asheryoung10/seniorProject/Pictures/BothSidesOfShell.jpg

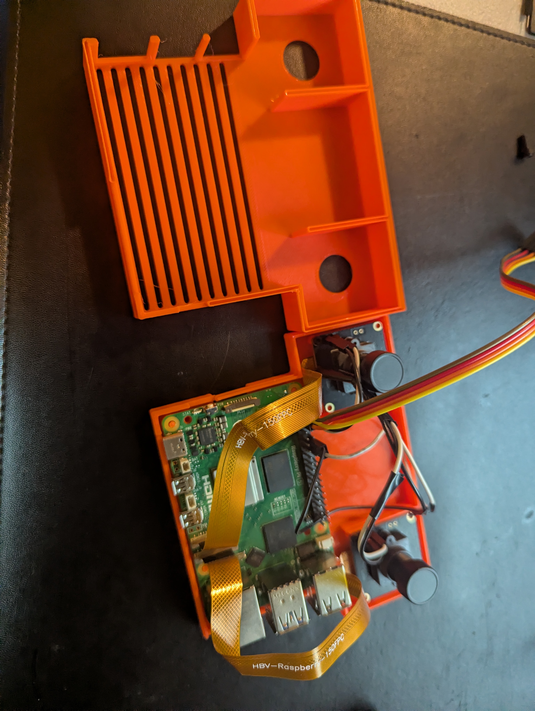
Pictures/BothSidesOfShell.jpg
