asheryoung10/seniorProject/Pictures/Cameras.webp

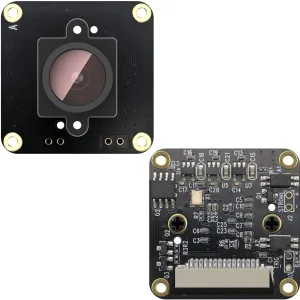
Pictures/Cameras.webp
