asheryoung10/seniorProject/Pictures/completeDevicePluggedIn.jpg

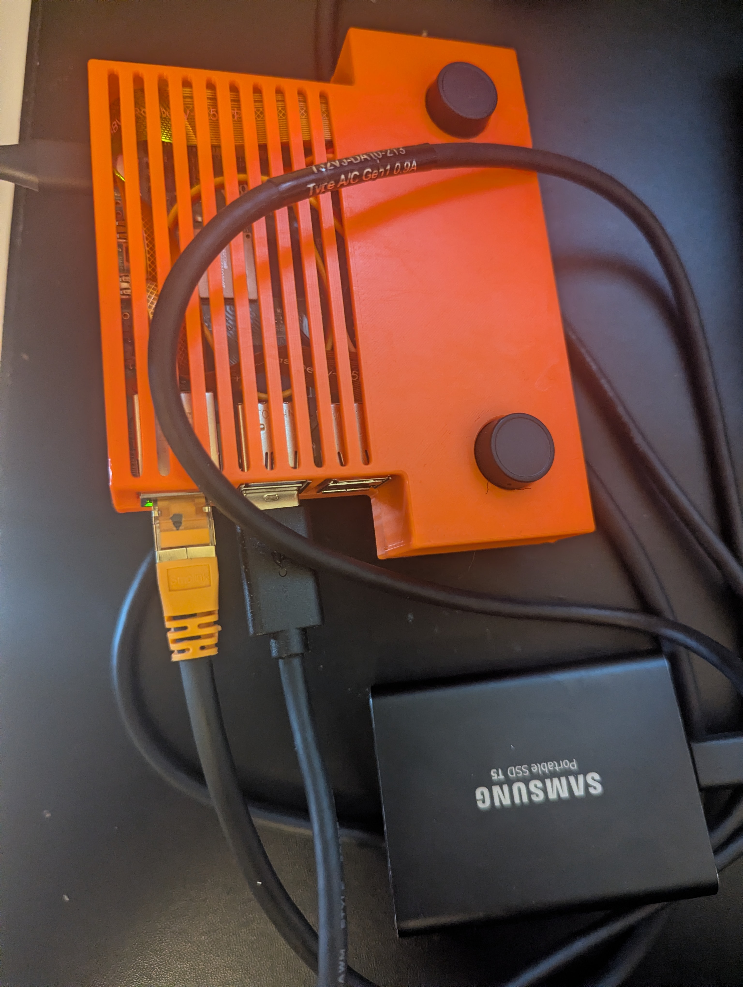
Pictures/completeDevicePluggedIn.jpg
