asheryoung10/seniorProject/Pictures/deviceNoTopShell.jpg

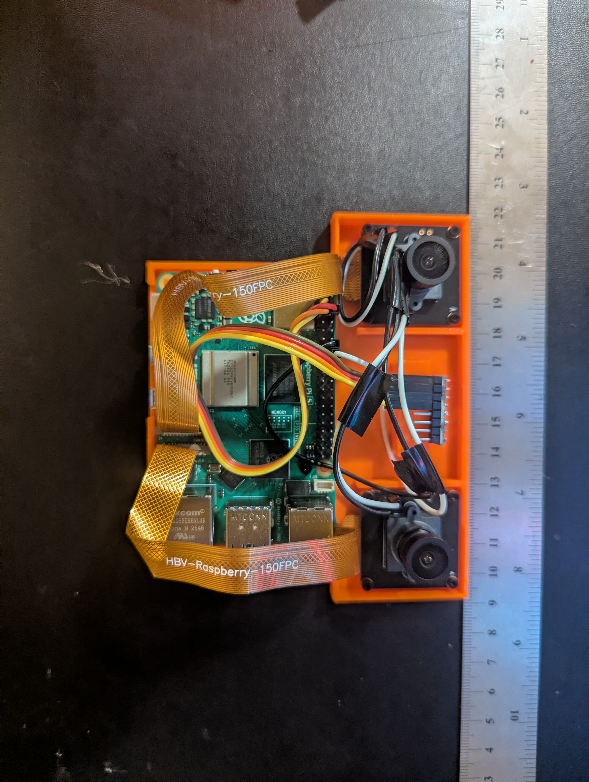
Pictures/deviceNoTopShell.jpg
