asheryoung10/seniorProject/Rasp_UPS_5A/KiCad/USB_UPS_Raspberry.csv

Reference | Qty | Value | DNP | Exclude from BOM | Footprint | MPN#
FID1,FID2,FID3 | 3 | Fiducial | DNP | Excluded from BOM | Fiducial:Fiducial_0.5mm_Mask1mm
U4 | 1 | BQ21040DBV |  |  | Package_TO_SOT_SMD:SOT-23-6 | BQ21040DBVR
U3 | 1 | BQ297xy |  |  | Package_SON:WSON-6_1.5x1.5mm_P0.5mm | BQ29700DSER
U2 | 1 | TPS61089 |  |  | Package_DFN_QFN:Texas_VQFN-RNR0011A-11 | TPS61089RNRR
U1 | 1 | BH-18650-B5BA016 |  |  | xresource_kicadlibrary:BH-18650-B5BA016 | BH-18650-B5BA016
R9 | 1 | 1k8 |  |  | Resistor_SMD:R_0603_1608Metric | RT0603BRD071K8L
R8 | 1 | 330 |  |  | Resistor_SMD:R_0603_1608Metric | RT0603BRE07330RL
R7,R11 | 2 | 2k2 |  |  | Resistor_SMD:R_0603_1608Metric | RT0603BRD072K2L
R5 | 1 | 33k |  |  | Resistor_SMD:R_0603_1608Metric | RT0603BRD0733KL
R4 | 1 | 17k4 |  |  | Resistor_SMD:R_0603_1608Metric | RT0603BRD0717K4L
R3 | 1 | 127k |  |  | Resistor_SMD:R_0603_1608Metric | RT0603FRE07127KL
R2 | 1 | 301k |  |  | Resistor_SMD:R_0603_1608Metric | RT0603BRE07301KL
R1,R6,R10 | 3 | 10k |  |  | Resistor_SMD:R_0603_1608Metric | RT0603BRD0710KL
Q2,Q3 | 2 | SI4134DY |  |  | Package_SO:SOIC-8_3.9x4.9mm_P1.27mm | SI4134DY-T1-GE3
Q1 | 1 | NTF6P02 |  |  | Package_TO_SOT_SMD:SOT-223-3_TabPin2 | NTF6P02T3G
L1 | 1 | 1u8 |  |  | Inductor_SMD:L_Bourns_SRP6060FA | YSPIT0630A-1R8M
J2 | 1 | USB_A |  |  | Connector_USB:USB_A_Connfly_DS1095 | DS1095-BNR0
J1 | 1 | USB_C_Receptacle_PowerOnly_6P |  |  | Connector_USB:USB_C_Receptacle_HRO_TYPE-C-31-M-17 | GT-USB-7002A
F1,F2 | 2 | 300C-8V |  |  | Fuse:Fuse_1206_3216Metric | SMD1206-300C-8V
D2 | 1 | LED |  |  | LED_SMD:LED_0603_1608Metric | LTST-C193KSKT-5A
D1 | 1 | PMEG100V060ELPDZ |  |  | Package_TO_SOT_SMD:Nexperia_CFP15_SOT-1289 | PMEG100V060ELPDZ
C8,C13,C14 | 3 | 1uF |  |  | Capacitor_SMD:C_0603_1608Metric | CC0603KRX5R8BB105
C7 | 1 | 4n7 |  |  | Capacitor_SMD:C_0603_1608Metric | CC0603KRX7R8BB472
C6 | 1 | 4u7 |  |  | Capacitor_SMD:C_0603_1608Metric | GRM188R61E475KE11D
C2,C3,C4,C9,C10,C11 | 6 | 22uF |  |  | Capacitor_SMD:C_0603_1608Metric | GRM188R61C226ME01D
C1,C5,C12 | 3 | 100nF |  |  | Capacitor_SMD:C_0603_1608Metric | CC0603KRX7R8BB104
