asheryoung10/seniorProject/CAD/Version2/assembly-front.stl

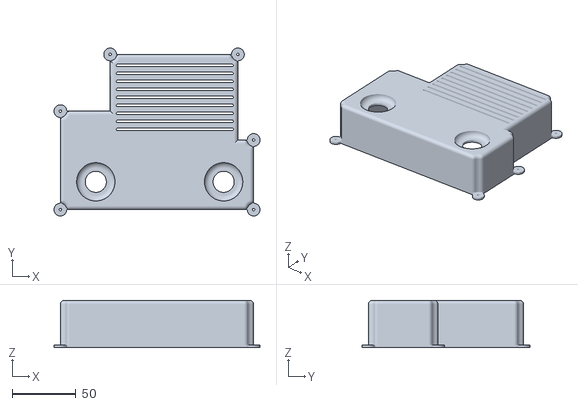
[picture p11: CAD file, 2026-10-17]
CAD/Version2/assembly-front.stl
161.2 x 131.4 x 37.0
