asheryoung10/seniorProject/CAD/Version2/assembly.FCStd

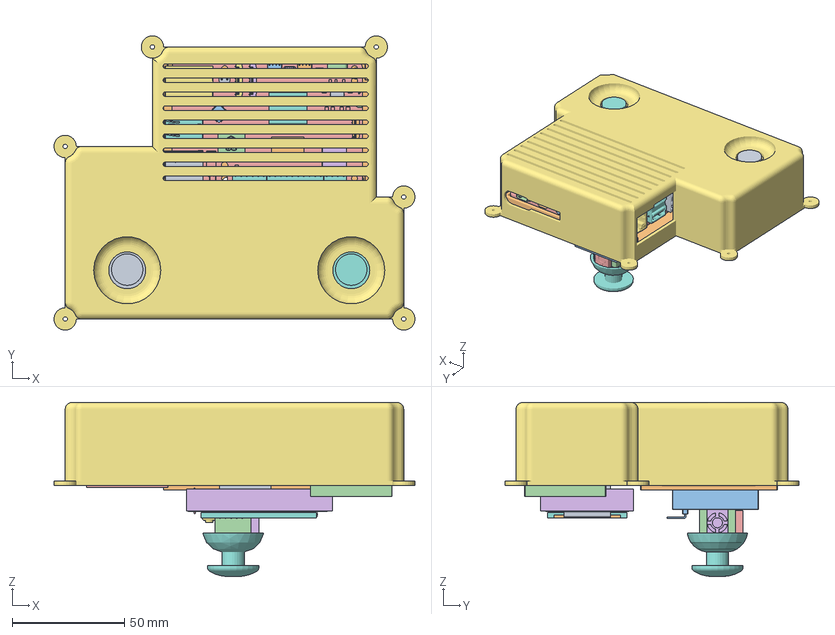
[picture p12: CAD file, 2026-10-17]
CAD/Version2/assembly.FCStd
161.1 x 131.4 x 77.7 mm
MPU6050 v001
MPU6050 v002
MPU6050 v003
MPU6050 v004
MPU6050 v005
MPU6050 v006
MPU6050 v007
MPU6050 v008
MPU6050 v009
MPU6050 v010
MPU6050 v011
MPU6050 v012
MPU6050 v013
MPU6050 v014
MPU6050 v015
MPU6050 v016
MPU6050 v017
MPU6050 v018
MPU6050 v019
MPU6050 v020
MPU6050 v021
MPU6050 v022
MPU6050 v023
MPU6050 v024
MPU6050 v025
MPU6050 v026
MPU6050 v027
MPU6050 v028
MPU6050 v029
MPU6050 v030
MPU6050 v031
MPU6050 v032
MPU6050 v033
MPU6050 v034
MPU6050 v035
MPU6050 v036
MPU6050 v037
MPU6050 v038
MPU6050 v039
MPU6050 v040
MPU6050 v041
MPU6050 v042
MPU6050 v043
MPU6050 v044
MPU6050 v045
MPU6050 v046
MPU6050 v047
MPU6050 v048
MPU6050 v049
MPU6050 v050
MPU6050 v051
MPU6050 v052
PLATE_RASPBERRY_PI_5
METAL_PLATE.
GIGABIT_ETHERNET_PORT
2xUSB_3.0_PORT
2xUSB_2.0_PORT
FEMALE_MICRO_HDMI_CONNECTOR
FEMALE_MICRO_HDMI_CONNECTOR001
FEMALE_USB_CONNECTOR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
