asheryoung10/seniorProject/CAD/Version2/assembly-back.stl

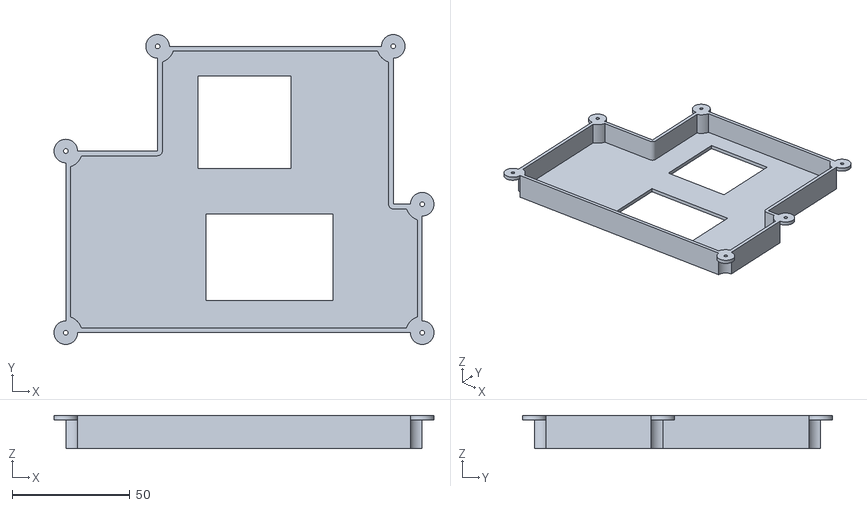
[picture p13: CAD file, 2026-10-17]
CAD/Version2/assembly-back.stl
161.2 x 131.4 x 14.0
