asheryoung10/seniorProject/CAD/RecorderHousing.3mf

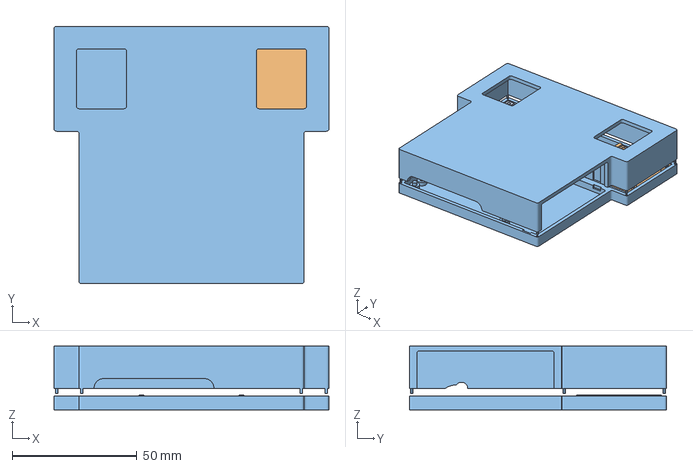
[picture p14: CAD file, 2026-08-28]
CAD/RecorderHousing.3mf
110.0 x 103.0 x 25.6 mm
