asheryoung10/seniorProject/CAD/Version2/6050Mount.FCStd

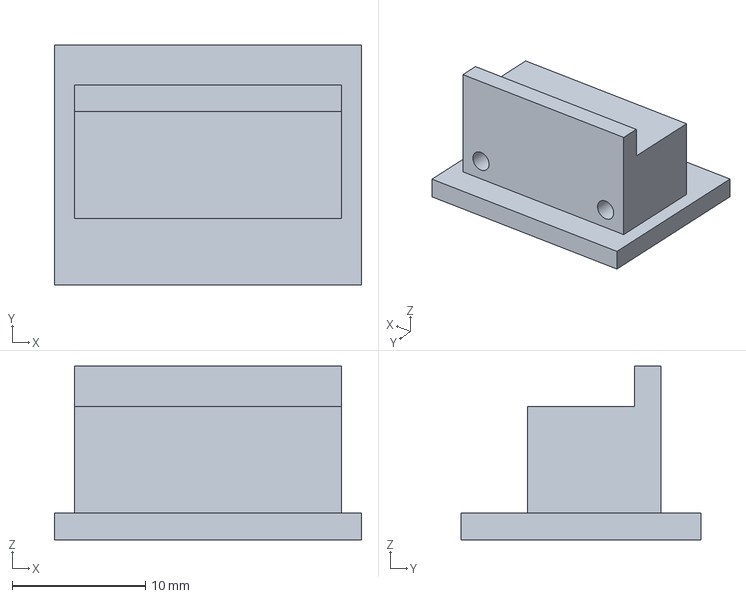
[picture p15: CAD file, 2026-10-17]
CAD/Version2/6050Mount.FCStd
23.0 x 18.0 x 13.0 mm
