asheryoung10/seniorProject/Rasp_UPS_5A/KiCad/USB_UPS_Raspberry.step

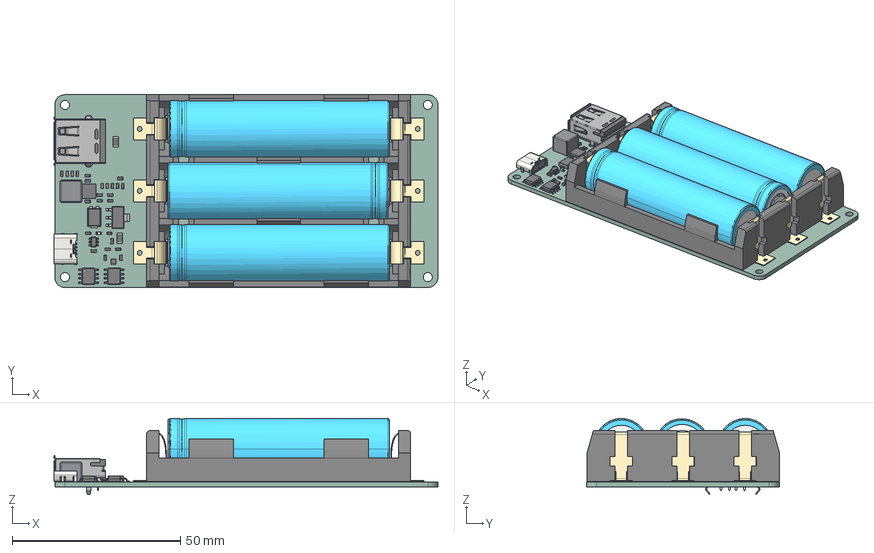
[picture p16: CAD file, 2026-10-31]
Rasp_UPS_5A/KiCad/USB_UPS_Raspberry.step
114.1 x 57.4 x 22.6 mm
C_0603_1608Metric x 14
Texas_S-PVQFN-N14
SOT-23-6
TO-277B
L_Bourns_SRP6060FA
R_0603_1608Metric x 11
Fuse_1206_3216Metric x 2
SOT-223
WSON-6_1.5x1.5mm_P0.5mm
SOIC-8_3.9x4.9mm_P1.27mm x 2
BatteryCasePlastic
BatteryCaseSpring x 6
Battery18650 x 3
LED_0603_1608Metric
USB_A_Molex_67643_Horizontal
USB_C_Receptacle_GCT_USB4125-xx-x_6P_TopMnt_Horizontal
USB_UPS_Raspberry_PCB
