asheryoung10/seniorProject/CAD/Version2/piMount.FCStd

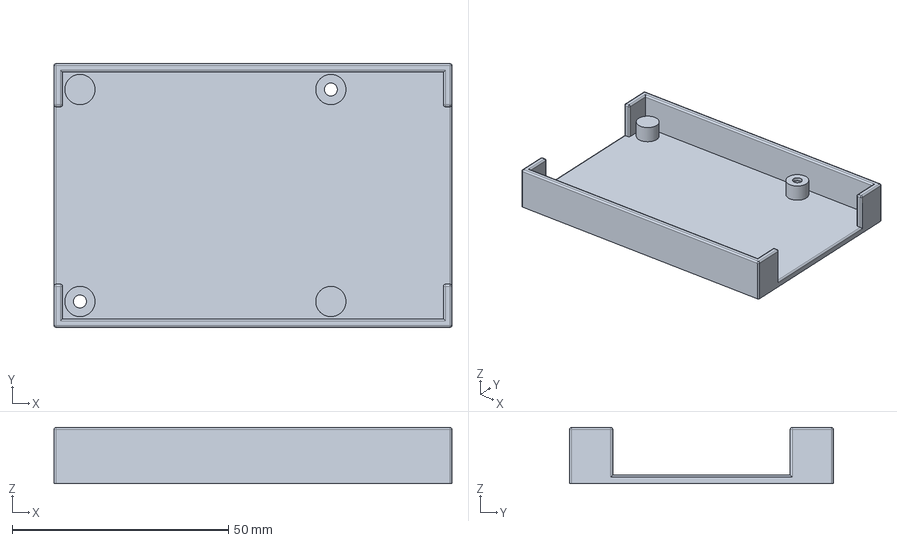
[picture p17: CAD file, 2026-10-17]
CAD/Version2/piMount.FCStd
92.0 x 61.0 x 13.0 mm
