asheryoung10/seniorProject/CAD/Version2/cameraMount.FCStd

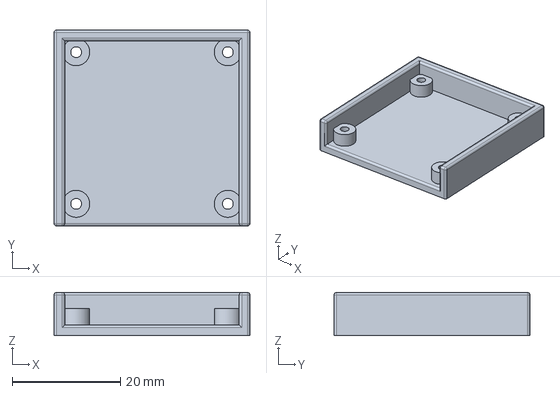
[picture p18: CAD file, 2026-10-17]
CAD/Version2/cameraMount.FCStd
36.2 x 36.2 x 8.00 mm
