asheryoung10/seniorProject/CAD/Version2/joystickMount.FCStd

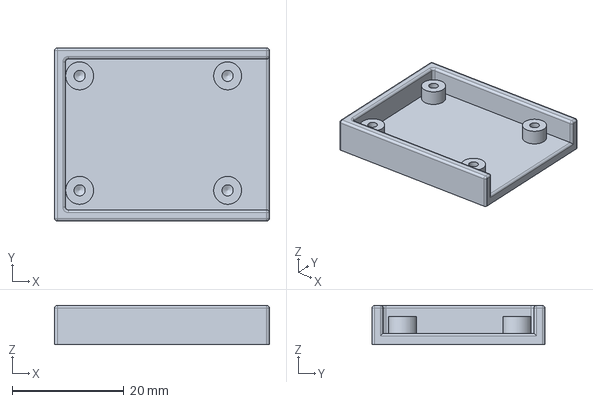
[picture p19: CAD file, 2026-10-17]
CAD/Version2/joystickMount.FCStd
38.5 x 31.0 x 7.00 mm
