asheryoung10/seniorProject/CAD/Version2/cameraModel.stl

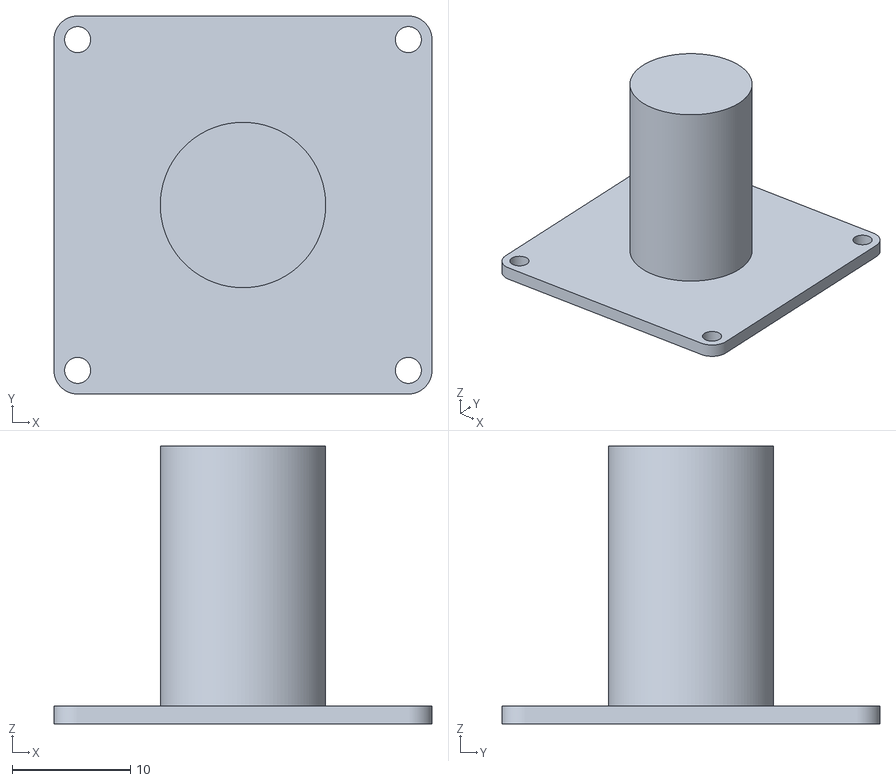
[picture p20: CAD file, 2026-10-17]
CAD/Version2/cameraModel.stl
32.0 x 32.0 x 23.5
