asheryoung10/seniorProject/CAD/Version2/displayMount-Body.stl

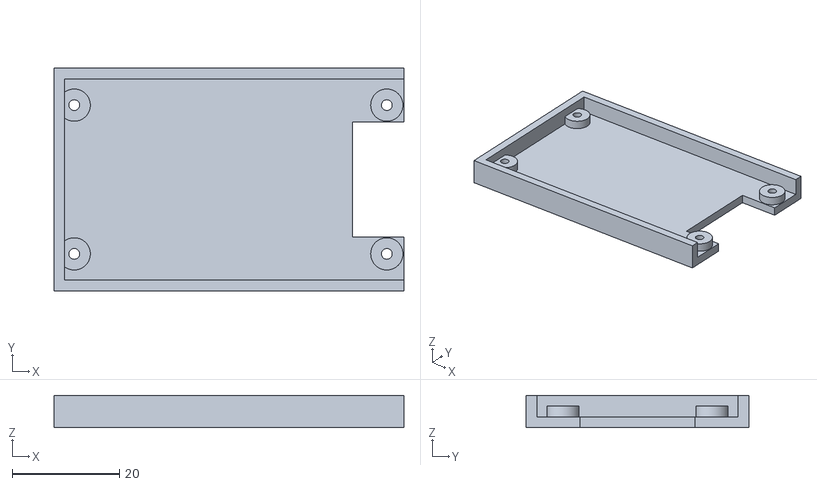
[picture p21: CAD file, 2026-10-17]
CAD/Version2/displayMount-Body.stl
65.2 x 41.5 x 6.00
