asheryoung10/seniorProject/CAD/Version2/base.stl

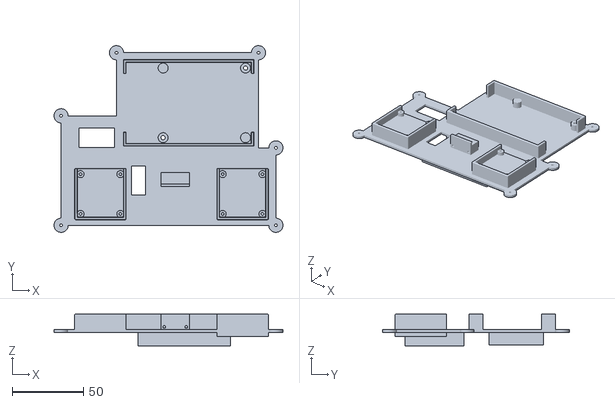
[picture p22: CAD file, 2026-10-17]
CAD/Version2/base.stl
161.2 x 131.4 x 22.5
