asheryoung10/seniorProject/CAD/Version2/displayMount.FCStd

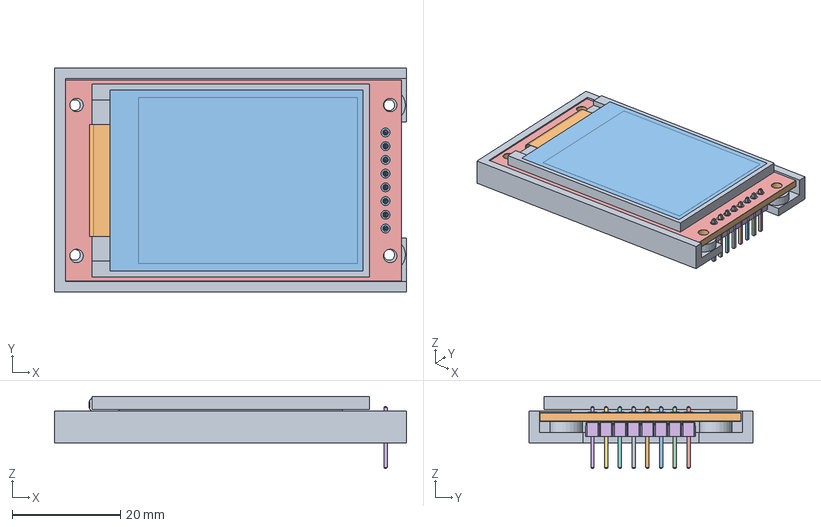
[picture p23: CAD file, 2026-10-17]
CAD/Version2/displayMount.FCStd
65.2 x 41.5 x 13.4 mm
Board
64-copper
1-soldermask
64-soldermask
6130xx11121_PIN
6130xx11121_PIN001
6130xx11121_PIN002
6130xx11121_PIN003
6130xx11121_PIN004
6130xx11121_PIN005
6130xx11121_PIN006
6130xx11121_PIN007
SOT23
DIODE_PGB-0603MP
DIODE_PGB-0603MP001
DIODE_PGB-0603MP002
DIODE_PGB-0603MP003
DIODE_PGB-0603MP004
5576557.f3d
5576557.f3d 001
5576557.f3d 002
5576557.f3d 003
5576557.f3d 004
5576557.f3d 005
5576557.f3d 006
CAP_0603
CAP_0604
SOT89
1-copper
Text
Screen support
Ribon cable
Glass
