asheryoung10/seniorProject/CAD/Version1/HousingVersion2-Bottom.3mf

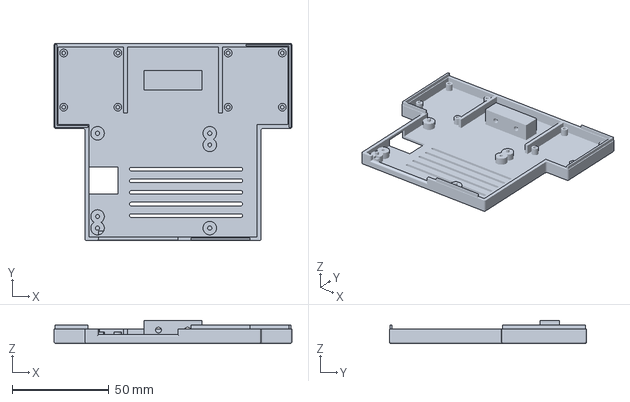
[picture p24: CAD file, 2026-10-17, an earlier design]
CAD/Version1/HousingVersion2-Bottom.3mf
123.0 x 102.0 x 12.0 mm
