asheryoung10/seniorProject/CAD/Version1/RecorderHousing-Bottom.3mf

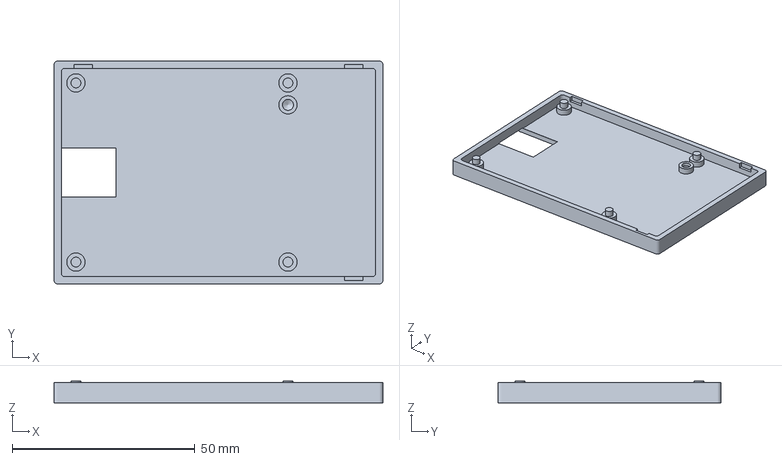
[picture p25: CAD file, 2026-10-17, an earlier design]
CAD/Version1/RecorderHousing-Bottom.3mf
90.0 x 61.0 x 6.00 mm
