asheryoung10/seniorProject/CAD/Version1/HousingVersion2-Cut.3mf

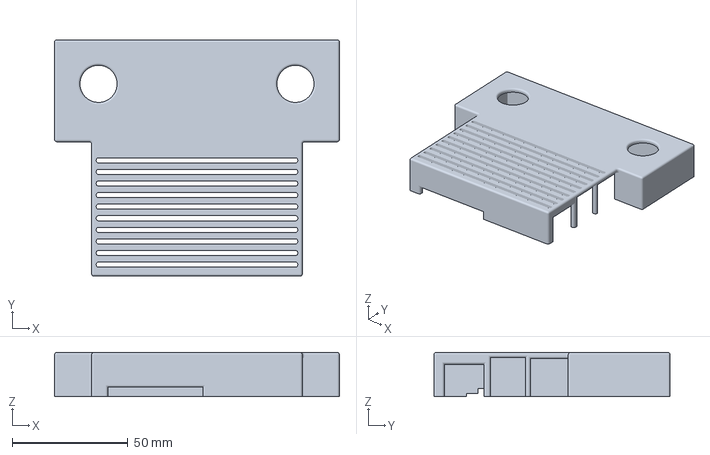
[picture p26: CAD file, 2026-10-17, an earlier design]
CAD/Version1/HousingVersion2-Cut.3mf
123.0 x 102.0 x 19.0 mm
