asheryoung10/seniorProject/CAD/Version1/HousingVersion2.FCStd

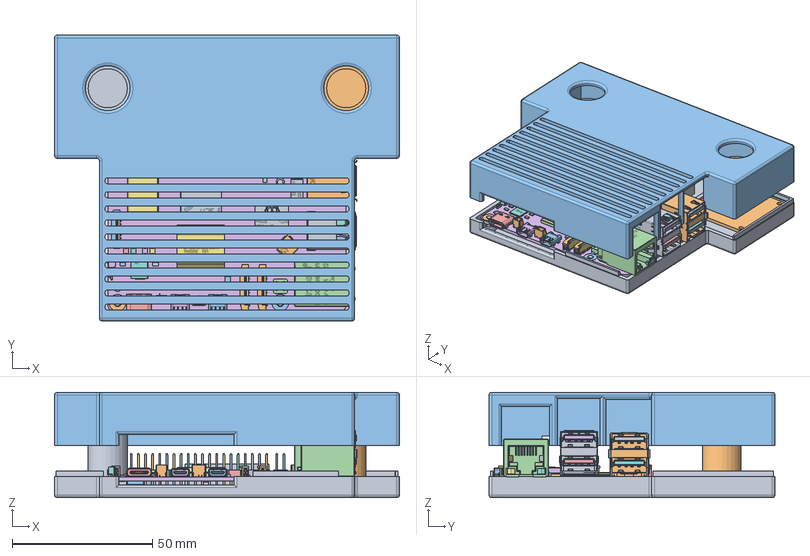
[picture p27: CAD file, 2026-10-17, an earlier design]
CAD/Version1/HousingVersion2.FCStd
123.0 x 102.0 x 37.6 mm
Bottom
PLATE_RASPBERRY_PI_5
PLATE_RASPBERRY_PI_001
PLATE_RASPBERRY_PI_002
PLATE_RASPBERRY_PI_003
PLATE_RASPBERRY_PI_004
METAL_PLATE.
GIGABIT_ETHERNET_PORT
GIGABIT_ETHERNET_PORT001
GIGABIT_ETHERNET_PORT002
GIGABIT_ETHERNET_PORT003
GIGABIT_ETHERNET_PORT004
GIGABIT_ETHERNET_PORT005
GIGABIT_ETHERNET_PORT006
GIGABIT_ETHERNET_PORT007
GIGABIT_ETHERNET_PORT008
GIGABIT_ETHERNET_PORT009
GIGABIT_ETHERNET_PORT010
GIGABIT_ETHERNET_PORT011
GIGABIT_ETHERNET_PORT012
GIGABIT_ETHERNET_PORT013
GIGABIT_ETHERNET_PORT014
GIGABIT_ETHERNET_PORT015
GIGABIT_ETHERNET_PORT016
GIGABIT_ETHERNET_PORT017
GIGABIT_ETHERNET_PORT018
GIGABIT_ETHERNET_PORT019
GIGABIT_ETHERNET_PORT020
GIGABIT_ETHERNET_PORT021
GIGABIT_ETHERNET_PORT022
GIGABIT_ETHERNET_PORT023
GIGABIT_ETHERNET_PORT024
GIGABIT_ETHERNET_PORT025
GIGABIT_ETHERNET_PORT026
GIGABIT_ETHERNET_PORT027
GIGABIT_ETHERNET_PORT028
GIGABIT_ETHERNET_PORT029
GIGABIT_ETHERNET_PORT030
GIGABIT_ETHERNET_PORT031
GIGABIT_ETHERNET_PORT032
GIGABIT_ETHERNET_PORT033
GIGABIT_ETHERNET_PORT034
GIGABIT_ETHERNET_PORT035
GIGABIT_ETHERNET_PORT036
2xUSB_3.0_PORT
2xUSB_3.0_PORT001
2xUSB_3.0_PORT002
2xUSB_3.0_PORT003
2xUSB_3.0_PORT004
2xUSB_3.0_PORT005
2xUSB_3.0_PORT006
2xUSB_3.0_PORT007
2xUSB_3.0_PORT008
2xUSB_3.0_PORT009
2xUSB_3.0_PORT010
2xUSB_3.0_PORT011
2xUSB_3.0_PORT012
2xUSB_3.0_PORT013
2xUSB_3.0_PORT014
2xUSB_3.0_PORT015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
