asheryoung10/seniorProject/(list of files, cad)

Other CAD files:
CAD/Version1/RecorderHousing.FCStd
CAD/Version1/slamPiHousing.FCStd
CAD/Version1/top.3mf
CAD/Version2/assembly.stl
Rasp_UPS_5A/KiCad/USB_UPS_Raspberry.stl
