asheryoung10/seniorProject/Rasp_UPS_5A/KiCad/USB_UPS_Raspberry.pdf

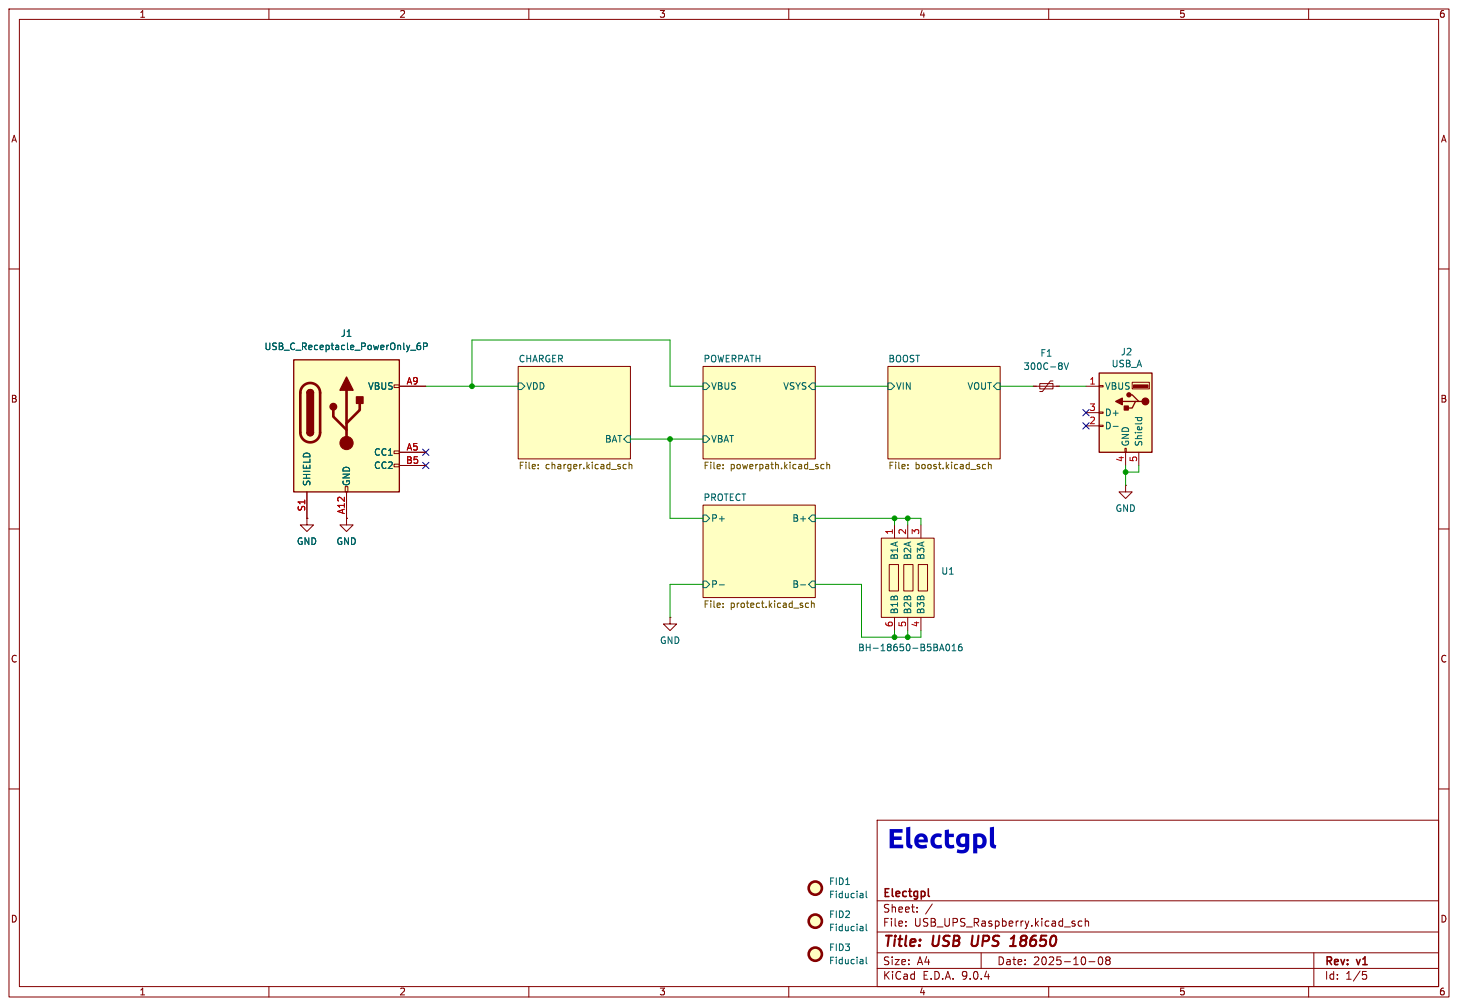
[picture p28: page 1]

File: boost.kicad_sch BAT VDD

4 U1 BH-18650-B5BA016 GND GND GND Electgpl

Id: 1/5 Title: USB UPS 18650

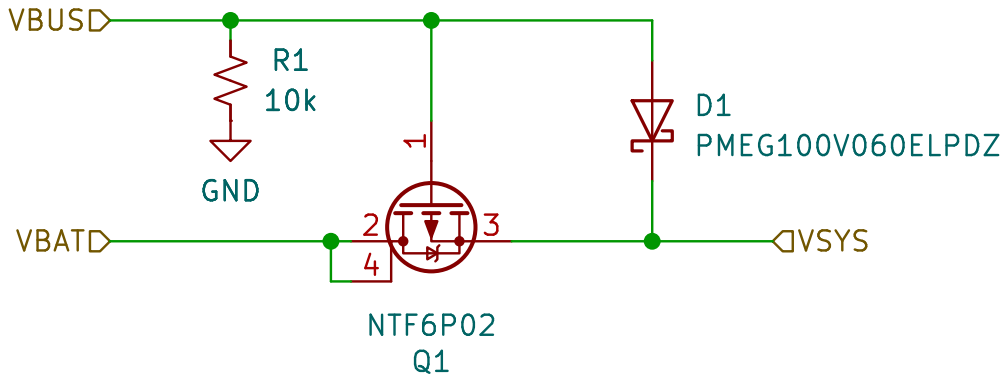
[picture p29: page 2]

VBAT VBUS
File: powerpath.kicad_sch Sheet: /POWERPATH/ Electgpl D1

Id: 2/5 Title: USB UPS 18650

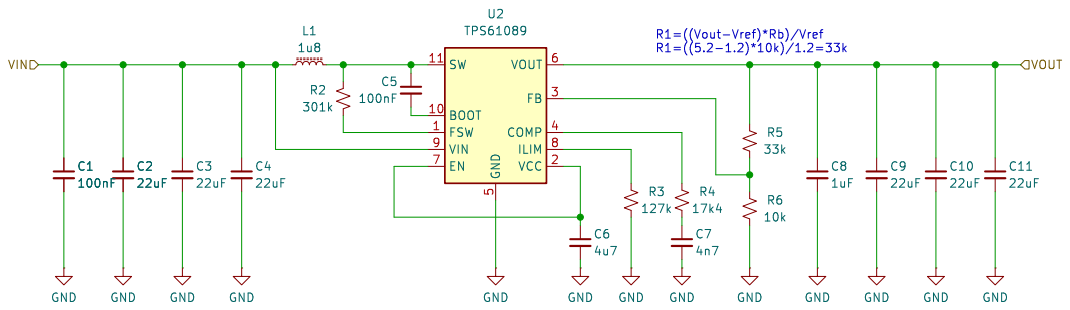
[picture p30: page 3]

File: boost.kicad_sch Sheet: /BOOST/ Electgpl

Id: 3/5 Title: USB UPS 18650

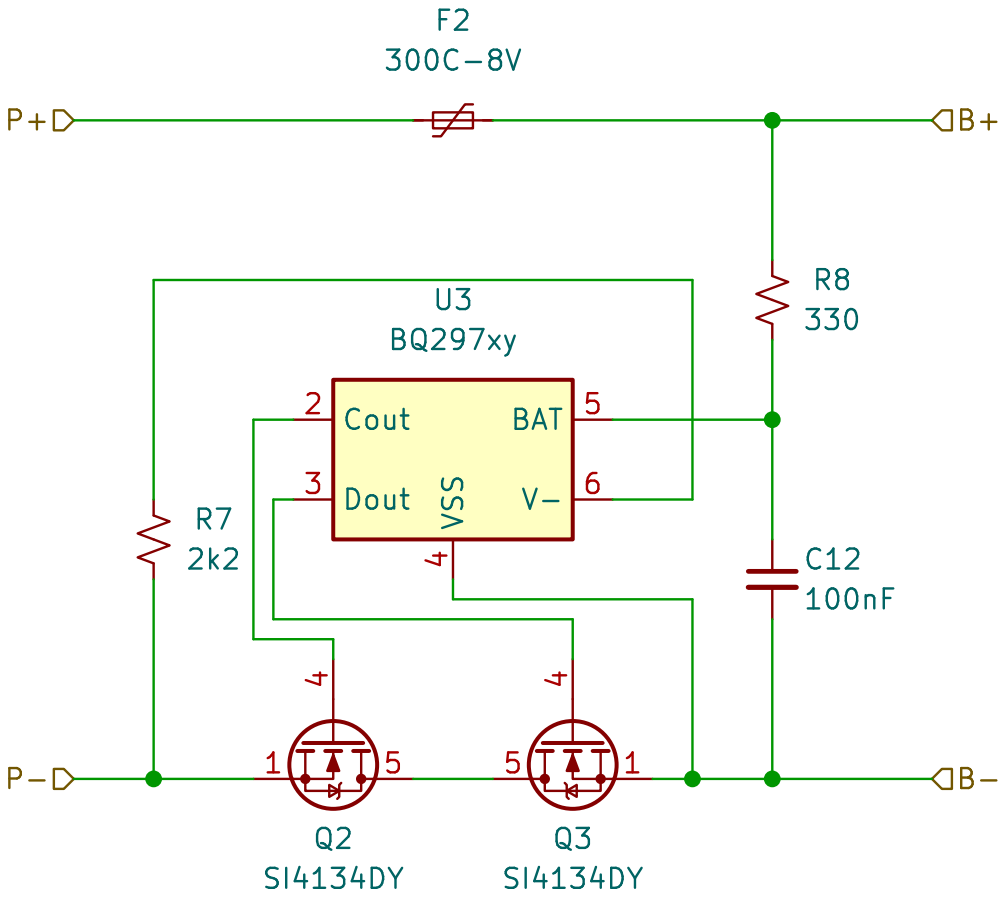
[picture p31: page 4]

File: protect.kicad_sch Sheet: /PROTECT/ Electgpl 4

Id: 4/5 Title: USB UPS 18650

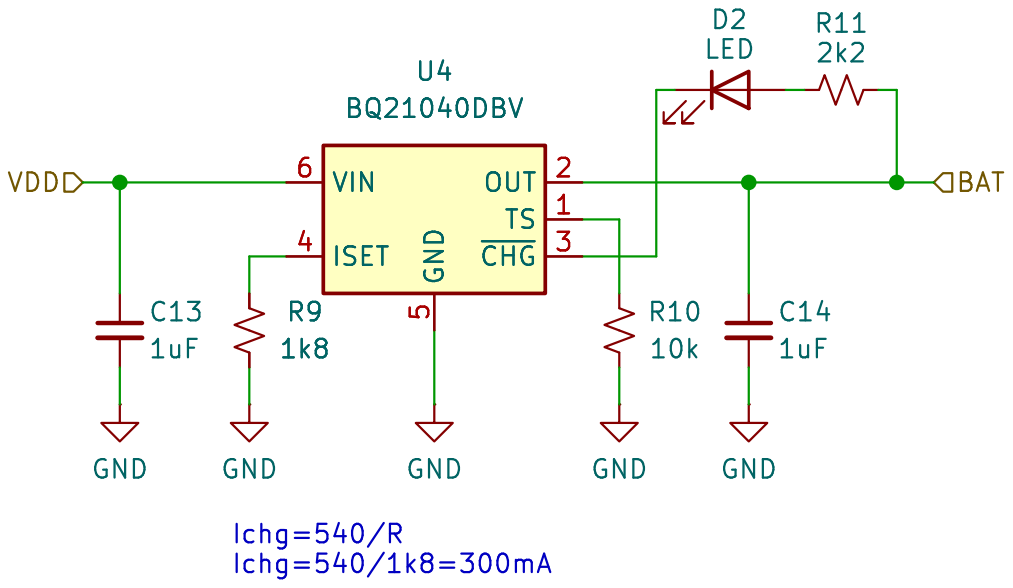
[picture p32: page 5]

File: charger.kicad_sch Sheet: /CHARGER/ Electgpl C13

Id: 5/5 Title: USB UPS 18650
