asheryoung10/seniorProject/(list of files, drawings)

Other design files:
Rasp_UPS_5A/KiCad/USB_UPS_Raspberry.dsn
