asheryoung10/seniorProject/Rasp_UPS_5A/KiCad/USB_UPS_Raspberry.kicad_pcb

## KiCad design Rasp_UPS_5A/KiCad/USB_UPS_Raspberry.kicad_pcb (2026-11-05)

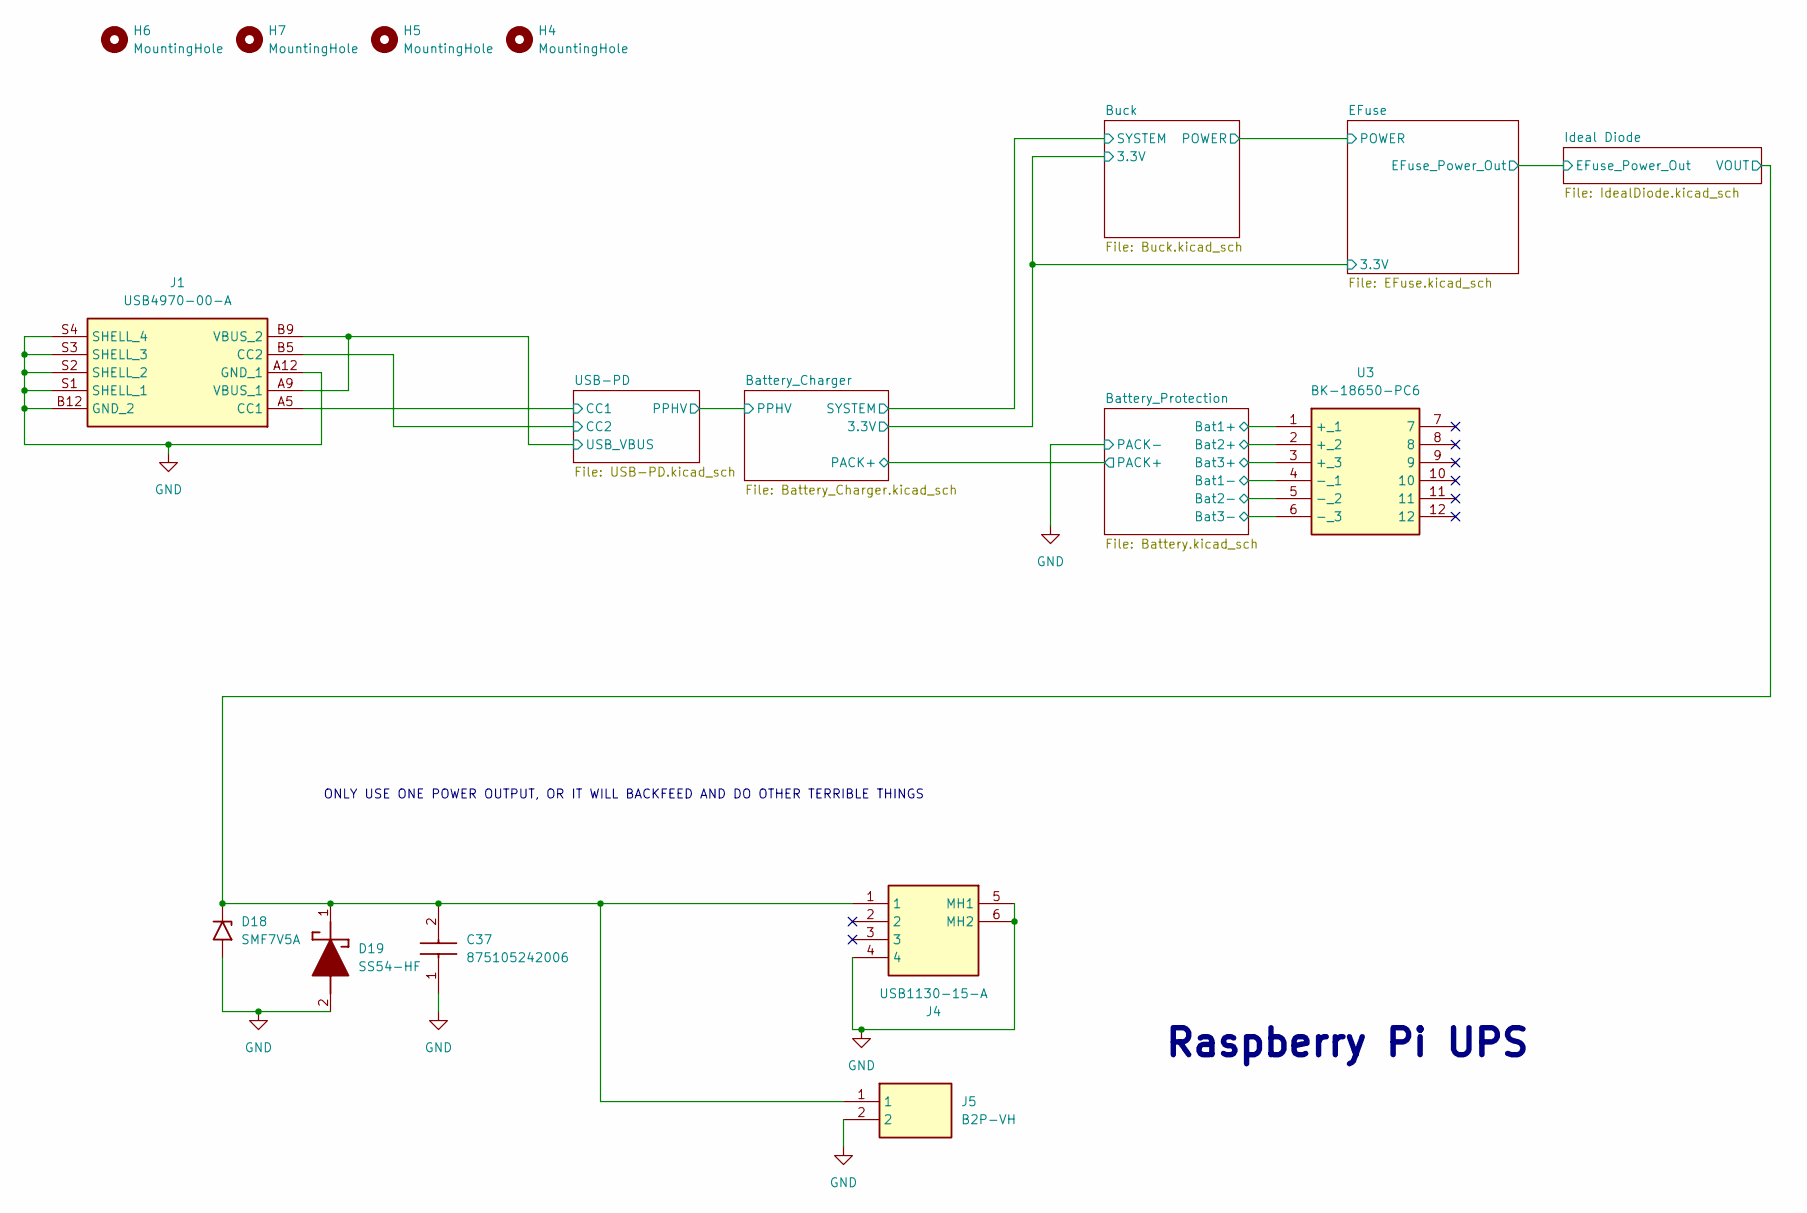
[picture p33: schematic USB_UPS_Raspberry.kicad_sch, USB UPS 18650]

Parts:
C37: 875105242006; CAPAE530X550N; Mouser Part Number 710-875105242006
D18: SMF7V5A; D_SMF
D19: SS54-HF; DIOM5025X220N; Mouser Part Number 750-SS54-HF
H4, H5, H6, H7: MountingHole; MountingHole_3.2mm_M3_Pad
J1: USB4970-00-A; USB497000A; Manufacturer_Part_Number USB4970-00-A
J4: USB1130-15-A; USB113015A; Mouser Part Number 640-USB1130-15-A
J5: B2P-VH; SHDR2W114P0X396_1X2_786X850X940P; Manufacturer_Part_Number B2P-VH
U3: BK-18650-PC6; BK18650PC6; Manufacturer_Part_Number BK-18650-PC6

Connections:
-BATT: U3.4 (-_1); also elsewhere on the board
/Battery_Charger/PACK+: U3.3 (+_3); also elsewhere on the board
/Battery_Protection/Bat1+: U3.1 (+_1), U3.5 (-_2); also elsewhere on the board
/Battery_Protection/Bat2+: U3.2 (+_2), U3.6 (-_3); also elsewhere on the board
/Ideal Diode/VOUT: C37.2 (-), D18.1 (A1), D19.1 (K), J4.1, J5.1; also elsewhere on the board
/USB-PD/CC1: J1.A5 (CC1); also elsewhere on the board
/USB-PD/CC2: J1.B5 (CC2); also elsewhere on the board
/USB-PD/VBUS: J1.A9 (VBUS_1), J1.B9 (VBUS_2); also elsewhere on the board
GND: C37.1 (+), D18.2 (A2), D19.2 (A), J1.A12 (GND_1), J1.B12 (GND_2), J1.S1 (SHELL_1), J1.S2 (SHELL_2), J1.S3 (SHELL_3), J1.S4 (SHELL_4), J4.4, J4.5 (MH1), J4.6 (MH2), J5.2; also elsewhere on the board

Notes on the sheet:
ONLY USE ONE POWER OUTPUT, OR IT WILL BACKFEED AND DO OTHER TERRIBLE THINGS
Raspberry Pi UPS

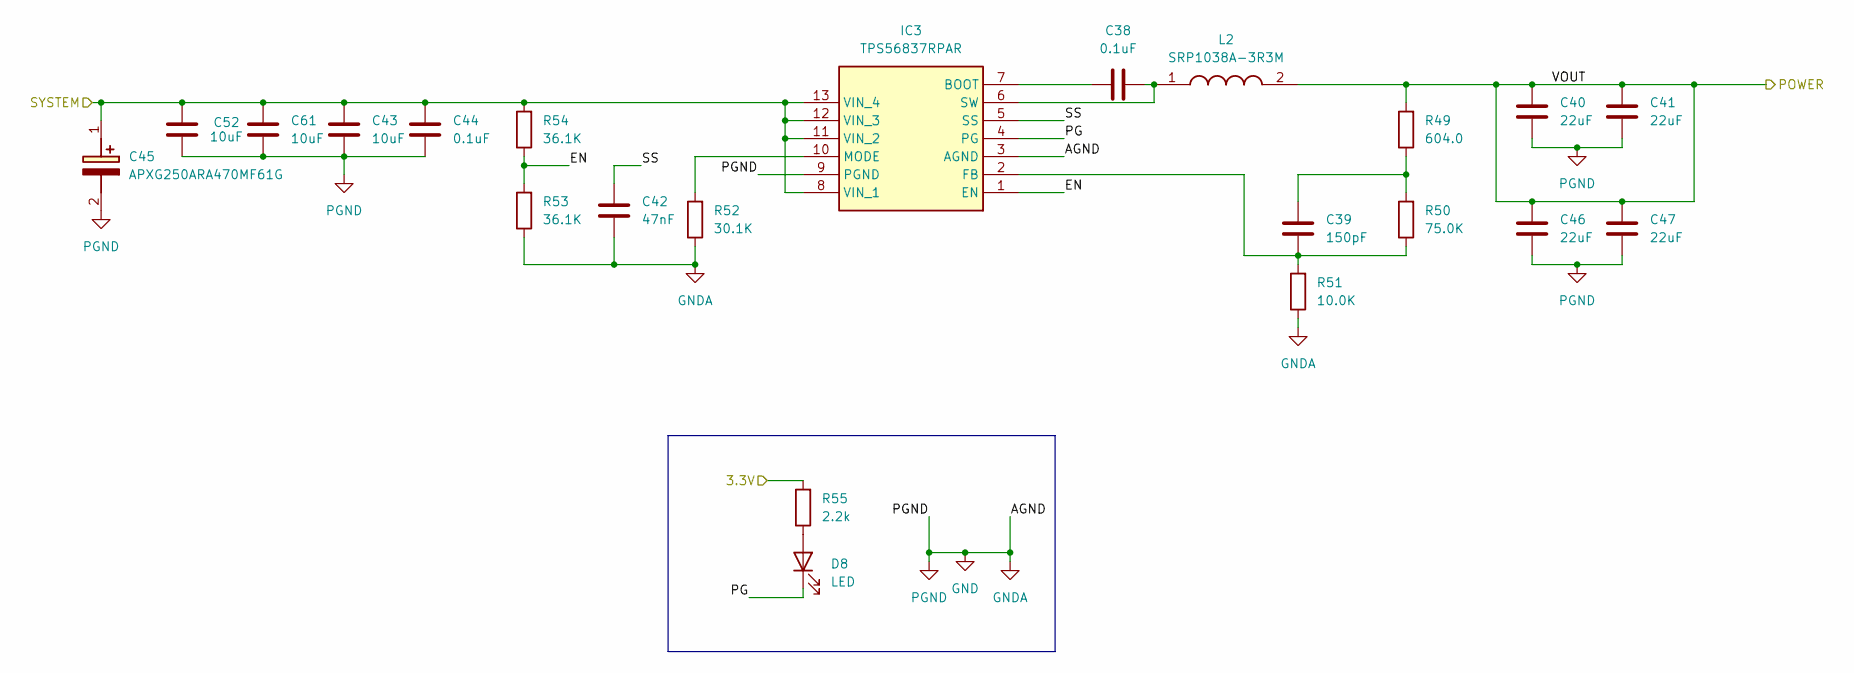
[picture p34: schematic Buck.kicad_sch]

Parts:
C38, C44: 0.1uF; C_0805_2012Metric
C39: 150pF; C_0805_2012Metric
C40, C41, C46, C47: 22uF; C_0805_2012Metric
C42: 47nF; C_0805_2012Metric
C43, C52, C61: 10uF; C_0805_2012Metric
C45: APXG250ARA470MF61G; CAPAE660X610N; Manufacturer_Part_Number APXG250ARA470MF61G; Mouser Part Number 661-APXG250A470MF61G
D8: LED; LED_0805_2012Metric
IC3: TPS56837RPAR; TPS56A37RPAR; Mouser Part Number 595-TPS56837RPAR
L2: SRP1038A-3R3M; INDPM110100X400N; Manufacturer_Part_Number SRP1038A-3R3M; Mouser Part Number 652-SRP1038A-3R3M
R49: 604.0; R_0805_2012Metric
R50: 75.0K; R_0805_2012Metric
R51: 10.0K; R_0805_2012Metric
R52: 30.1K; R_0805_2012Metric
R53, R54: 36.1K; R_0805_2012Metric
R55: 2.2k; R_0805_2012Metric

Connections:
/Battery_Charger/SYSTEM: C43.1, C44.1, C45.1 (+), C52.1, C61.1, IC3.8 (VIN_1), IC3.11 (VIN_2), IC3.12 (VIN_3), IC3.13 (VIN_4), R54.2; also elsewhere on the board
/Battery_Charger/VREF: R55.2; also elsewhere on the board
/Buck/EN: IC3.1 (EN), R53.2, R54.1
/Buck/PG: D8.1 (K), IC3.4 (PG)
/Buck/SS: C42.1, IC3.5 (SS)
/Buck/VOUT: C40.2, C41.2, C46.2, C47.2, L2.2, R49.2; also elsewhere on the board
GND: C40.1, C41.1, C42.2, C43.2, C44.2, C45.2 (-), C46.1, C47.1, C52.2, C61.2, IC3.3 (AGND), IC3.9 (PGND), R51.1, R52.1, R53.1; also elsewhere on the board
unnamed: C39.2, R49.1, R50.2
unnamed: D8.2 (A), R55.1
unnamed: C38.1, IC3.7 (BOOT)
unnamed: C39.1, IC3.2 (FB), R50.1, R51.2
unnamed: IC3.10 (MODE), R52.2
unnamed: C38.2, IC3.6 (SW), L2.1

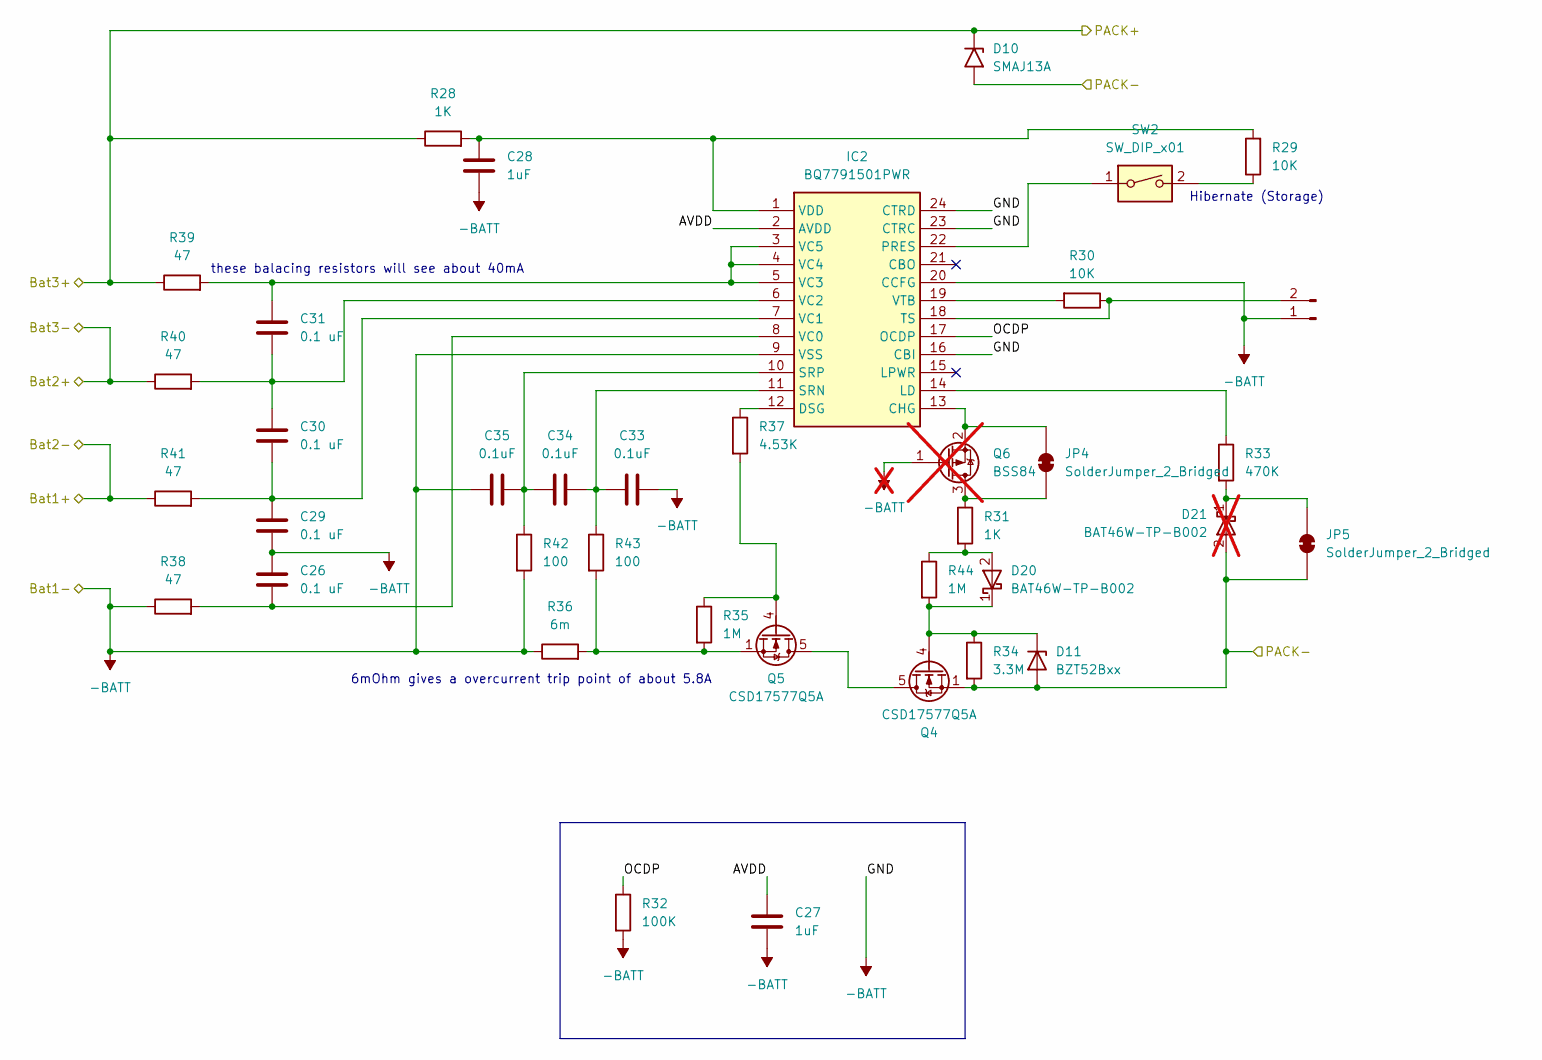
[picture p35: schematic Battery.kicad_sch]

Parts:
C26, C29, C30, C31: 0.1 uF; C_0805_2012Metric
C27, C28: 1uF; C_0805_2012Metric
C33, C34, C35: 0.1uF; C_0805_2012Metric
D10: SMAJ13A; D_SMA
D11: BZT52Bxx; D_SOD-123F
D20: BAT46W-TP-B002; SOD3716X135N; Manufacturer_Part_Number BAT46W-TP-B002
D21: BAT46W-TP-B002; SOD3716X135N; Manufacturer_Part_Number BAT46W-TP-B002; not fitted
IC2: BQ7791501PWR; SOP65P640X120-24N; Mouser Part Number 595-BQ7791501PWR
J3: Conn_01x02_Pin; PinHeader_1x02_P2.54mm_Vertical
JP4, JP5: SolderJumper_2_Bridged; SolderJumper-2_P1.3mm_Bridged_Pad1.0x1.5mm
Q4, Q5: CSD17577Q5A; TDSON-8-1
Q6: BSS84; SOT-23; not fitted
R28, R31: 1K; R_0805_2012Metric
R29, R30: 10K; R_0805_2012Metric
R32: 100K; R_0805_2012Metric
R33: 470K; R_0805_2012Metric
R34: 3.3M; R_0805_2012Metric
R35, R44: 1M; R_0805_2012Metric
R36: 6m; R_1206_3216Metric
R37: 4.53K; R_0805_2012Metric
R38, R39, R40, R41: 47; R_1206_3216Metric
R42, R43: 100; R_0805_2012Metric
SW2: SW_DIP_x01; SW_DIP_SPSTx01_Slide_6.7x4.1mm_W7.62mm_P2.54mm_LowProfile

Connections:
-BATT: C26.1, C27.2, C28.2, C29.2, C33.2, C35.1, IC2.9 (VSS), IC2.16 (CBI), IC2.20 (CCFG), IC2.23 (CTRC), IC2.24 (CTRD), J3.1, Q6.1 (G), R32.2, R36.1, R38.1, R42.2; also elsewhere on the board
/Battery_Charger/PACK+: D10.1 (A1), R28.1, R39.1; also elsewhere on the board
/Battery_Protection/AVDD: C27.1, IC2.2 (AVDD)
/Battery_Protection/Bat1+: R41.1; also elsewhere on the board
/Battery_Protection/Bat2+: R40.1; also elsewhere on the board
/Battery_Protection/OCDP: IC2.17 (OCDP), R32.1
GND: D10.2 (A2), D11.2 (A), D21.2 (A), JP5.1 (A), Q4.1 (S), Q4.2 (S), Q4.3 (S), R34.2; also elsewhere on the board
unnamed: D11.1 (K), D20.1 (K), Q4.4 (G), R34.1, R44.2
unnamed: D20.2 (A), R31.2, R44.1
unnamed: D21.1 (K), JP5.2 (B), R33.2
unnamed: IC2.13 (CHG), JP4.2 (B), Q6.2 (S)
unnamed: IC2.12 (DSG), R37.1
unnamed: IC2.14 (LD), R33.1
unnamed: IC2.22 (PRES), SW2.1
unnamed: C33.1, C34.2, IC2.11 (SRN), R43.1
unnamed: C34.1, C35.2, IC2.10 (SRP), R42.1
unnamed: IC2.18 (TS), J3.2, R30.1
unnamed: C26.2, IC2.8 (VC0), R38.2
unnamed: C29.1, C30.2, IC2.7 (VC1), R41.2
unnamed: C30.1, C31.2, IC2.6 (VC2), R40.2
unnamed: C31.1, IC2.3 (VC5), IC2.4 (VC4), IC2.5 (VC3), R39.2
unnamed: C28.1, IC2.1 (VDD), R28.2, R29.2
unnamed: IC2.19 (VTB), R30.2
unnamed: JP4.1 (A), Q6.3 (D), R31.1
unnamed: Q4.5 (D), Q5.5 (D)
unnamed: Q5.4 (G), R35.1, R37.2
unnamed: Q5.1 (S), Q5.2 (S), Q5.3 (S), R35.2, R36.2, R43.2
unnamed: R29.1, SW2.2

Notes on the sheet:
Hibernate (Storage)
these balacing resistors will see about 40mA
6mOhm gives a overcurrent trip point of about 5.8A

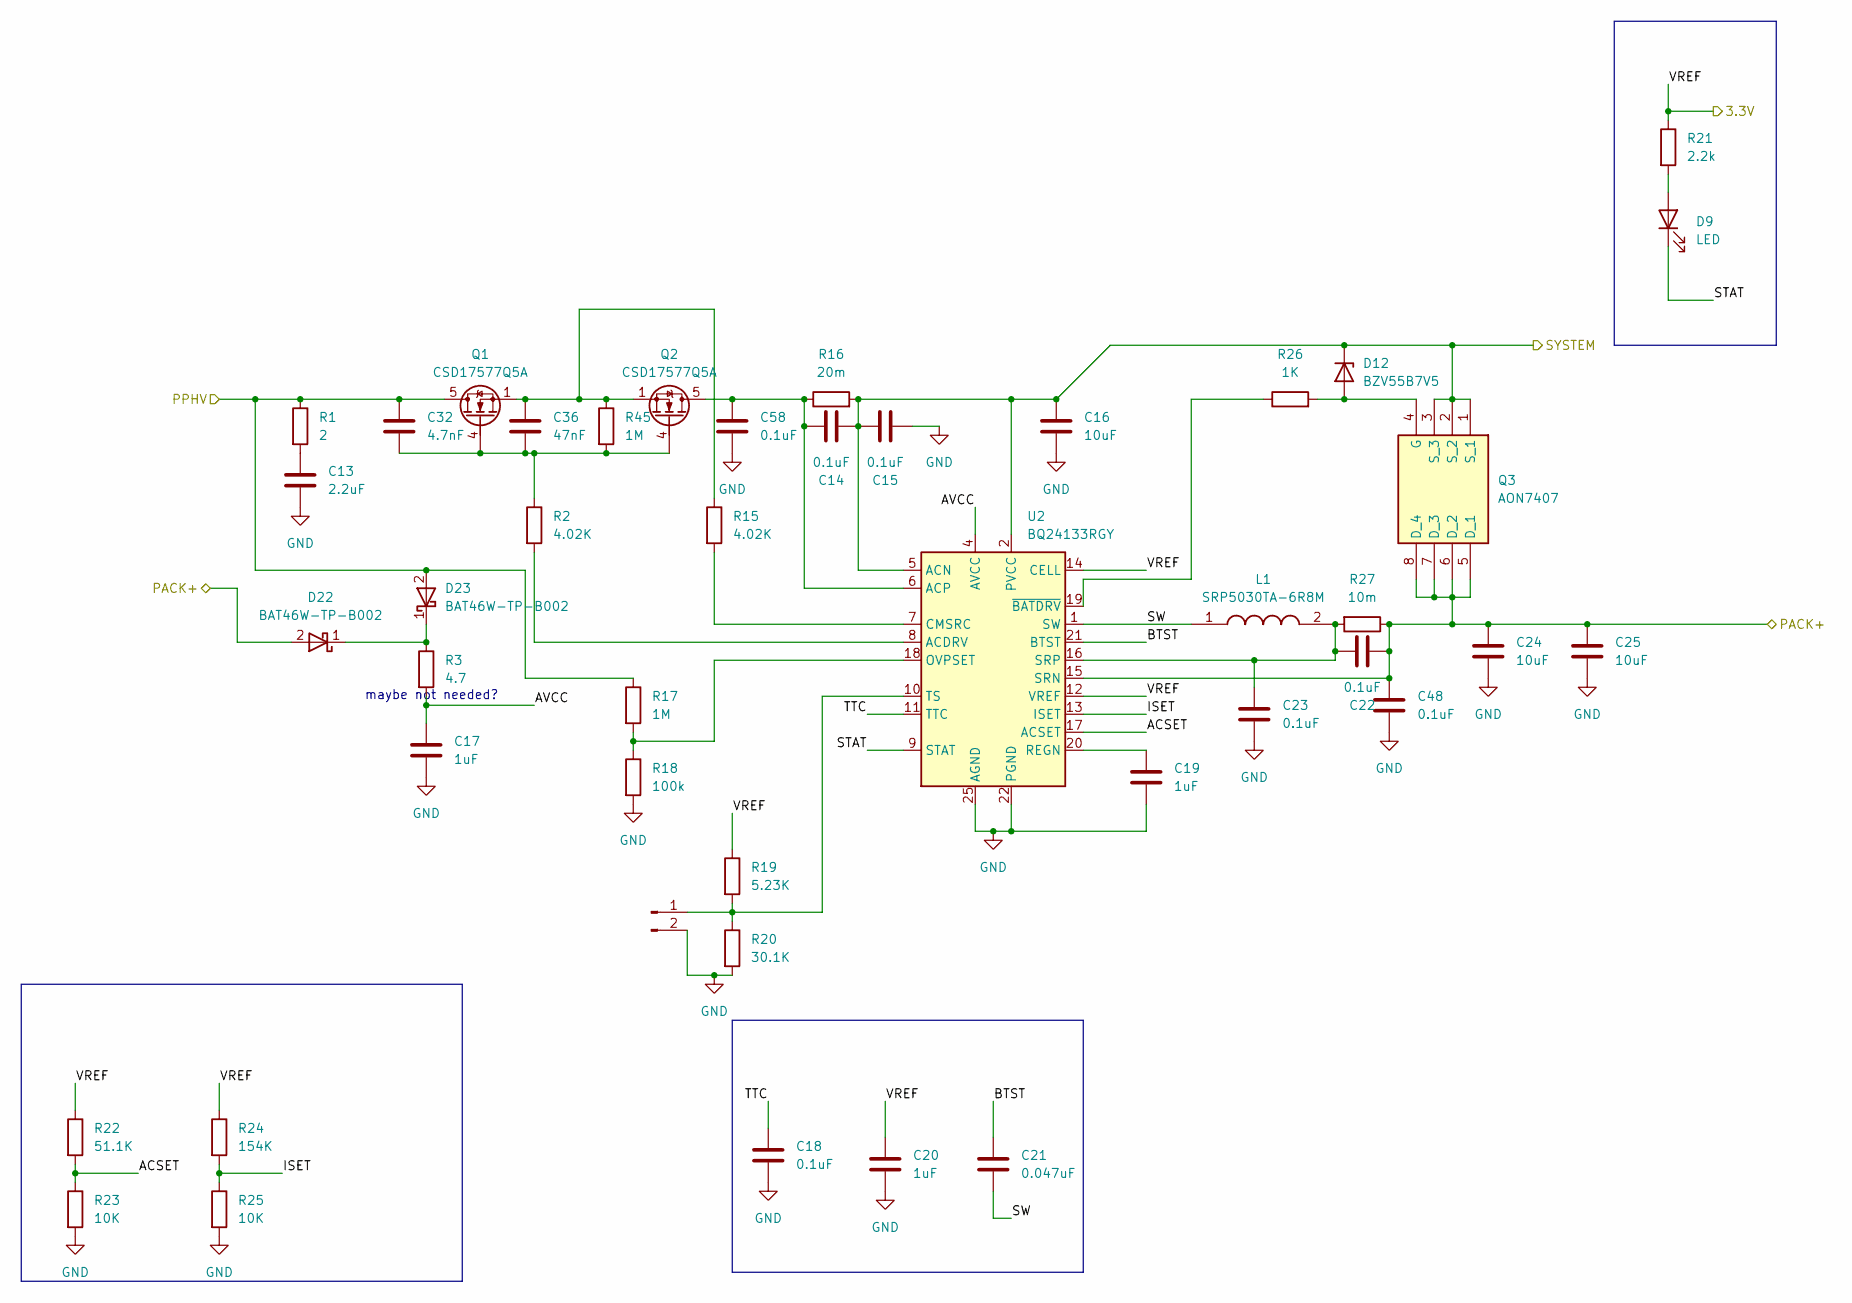
[picture p36: schematic Battery_Charger.kicad_sch]

Parts:
C13: 2.2uF; C_0805_2012Metric
C14, C15, C18, C22, C23, C48, C58: 0.1uF; C_0805_2012Metric
C16, C24, C25: 10uF; C_0805_2012Metric
C17, C19, C20: 1uF; C_0805_2012Metric
C21: 0.047uF; C_0805_2012Metric
C32: 4.7nF; C_0805_2012Metric
C36: 47nF; C_0805_2012Metric
D9: LED; LED_0805_2012Metric
D12: BZV55B7V5; D_MiniMELF
D22, D23: BAT46W-TP-B002; SOD3716X135N; Manufacturer_Part_Number BAT46W-TP-B002
J2: Conn_01x02_Pin; PinHeader_1x02_P2.54mm_Vertical
L1: SRP5030TA-6R8M; INDPM5752X300N; Manufacturer_Part_Number SRP5030TA-6R8M; Mouser Part Number 652-SRP5030TA-6R8M
Q1, Q2: CSD17577Q5A; TDSON-8-1
Q3: AON7407; DFN_3X3_EP; Manufacturer_Part_Number AON7407
R1: 2; R_0805_2012Metric
R2, R15: 4.02K; R_0805_2012Metric
R3: 4.7; R_0805_2012Metric
R16: 20m; R_1206_3216Metric
R17, R45: 1M; R_0805_2012Metric
R18: 100k; R_0805_2012Metric
R19: 5.23K; R_0805_2012Metric
R20: 30.1K; R_0805_2012Metric
R21: 2.2k; R_0805_2012Metric
R22: 51.1K; R_0805_2012Metric
R23, R25: 10K; R_0805_2012Metric
R24: 154K; R_0805_2012Metric
R26: 1K; R_0805_2012Metric
R27: 10m; R_1206_3216Metric
U2: BQ24133RGY; Texas_RGY_R-PVQFN-N24_EP2.05x3.1mm

Connections:
/Battery_Charger/ACSET: R22.2, R23.1, U2.17 (ACSET)
/Battery_Charger/AVCC: C17.1, R3.2, U2.4 (AVCC)
/Battery_Charger/BTST: C21.1, U2.21 (BTST)
/Battery_Charger/ISET: R24.2, R25.1, U2.13 (ISET)
/Battery_Charger/PACK+: C22.2, C24.2, C25.2, C48.2, D22.2 (A), Q3.5 (D_1), Q3.6 (D_2), Q3.7 (D_3), Q3.8 (D_4), Q3.9, Q3.10, Q3.11, R27.1, U2.15 (SRN); also elsewhere on the board
/Battery_Charger/STAT: D9.1 (K), U2.9 (STAT)
/Battery_Charger/SW: C21.2, L1.1, U2.1 (SW), U2.24 (SW)
/Battery_Charger/SYSTEM: C14.2, C15.1, C16.1, D12.1 (K), Q3.1 (S_1), Q3.2 (S_2), Q3.3 (S_3), R16.2, U2.2 (PVCC), U2.3 (PVCC), U2.5 (ACN); also elsewhere on the board
/Battery_Charger/TTC: C18.1, U2.11 (TTC)
/Battery_Charger/VREF: C20.1, R19.1, R21.1, R22.1, R24.1, U2.12 (VREF), U2.14 (CELL); also elsewhere on the board
/USB-PD/PPHV: C32.1, D23.2 (A), Q1.5 (D), R1.1, R17.1; also elsewhere on the board
GND: C13.2, C15.2, C16.2, C17.2, C18.2, C19.2, C20.2, C23.1, C24.1, C25.1, C48.1, C58.1, J2.2, R18.2, R20.2, R23.2, R25.2, U2.22 (PGND), U2.23 (PGND), U2.25 (AGND); also elsewhere on the board
unnamed: C13.1, R1.2
unnamed: C36.1, Q1.1 (S), Q1.2 (S), Q1.3 (S), Q2.1 (S), Q2.2 (S), Q2.3 (S), R15.1, R45.1
unnamed: D9.2 (A), R21.2
unnamed: D12.2 (A), Q3.4 (G), R26.2
unnamed: D22.1 (K), D23.1 (K), R3.1
unnamed: J2.1, R19.2, R20.1, U2.10 (TS)
unnamed: C32.2, C36.2, Q1.4 (G), Q2.4 (G), R2.1, R45.2
unnamed: C14.1, C58.2, Q2.5 (D), R16.1, U2.6 (ACP)
unnamed: R2.2, U2.8 (ACDRV)
unnamed: R15.2, U2.7 (CMSRC)
unnamed: R17.2, R18.1, U2.18 (OVPSET)
unnamed: C19.1, U2.20 (REGN)
unnamed: C22.1, C23.2, L1.2, R27.2, U2.16 (SRP)
unnamed: R26.1, U2.19 (~BATDRV)

Notes on the sheet:
maybe not needed?

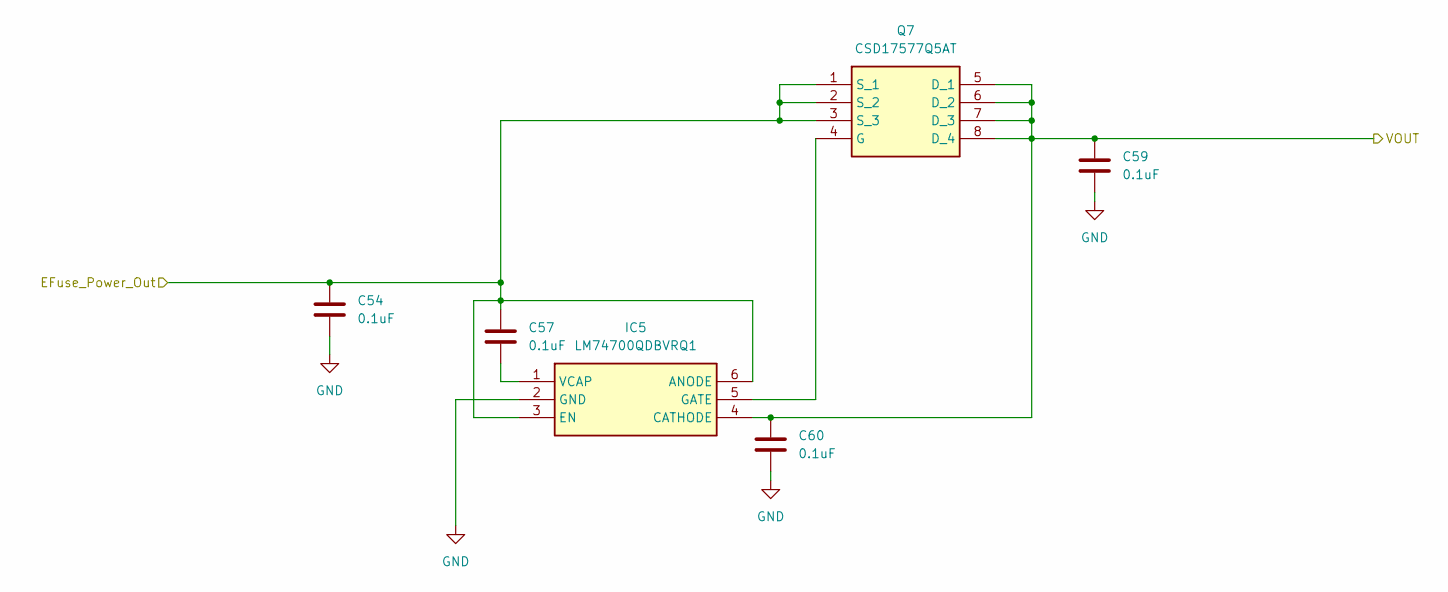
[picture p37: schematic IdealDiode.kicad_sch]

Parts:
C54, C57, C59, C60: 0.1uF; C_0805_2012Metric
IC5: LM74700QDBVRQ1; SOT95P280X145-6N; Mouser Part Number 595-LM74700QDBVRQ1
Q7: CSD17577Q5AT; CSD17310Q5A; Manufacturer_Part_Number CSD17577Q5AT; Mouser Part Number 595-CSD17577Q5AT

Connections:
/EFuse/EFuse_Power_Out: C54.1, C57.1, IC5.3 (EN), IC5.6 (ANODE), Q7.1 (S_1), Q7.2 (S_2), Q7.3 (S_3); also elsewhere on the board
/Ideal Diode/VOUT: C59.1, C60.1, IC5.4 (CATHODE), Q7.5 (D_1), Q7.6 (D_2), Q7.7 (D_3), Q7.8 (D_4), Q7.9; also elsewhere on the board
GND: C54.2, C59.2, C60.2, IC5.2 (GND); also elsewhere on the board
unnamed: IC5.5 (GATE), Q7.4 (G)
unnamed: C57.2, IC5.1 (VCAP)

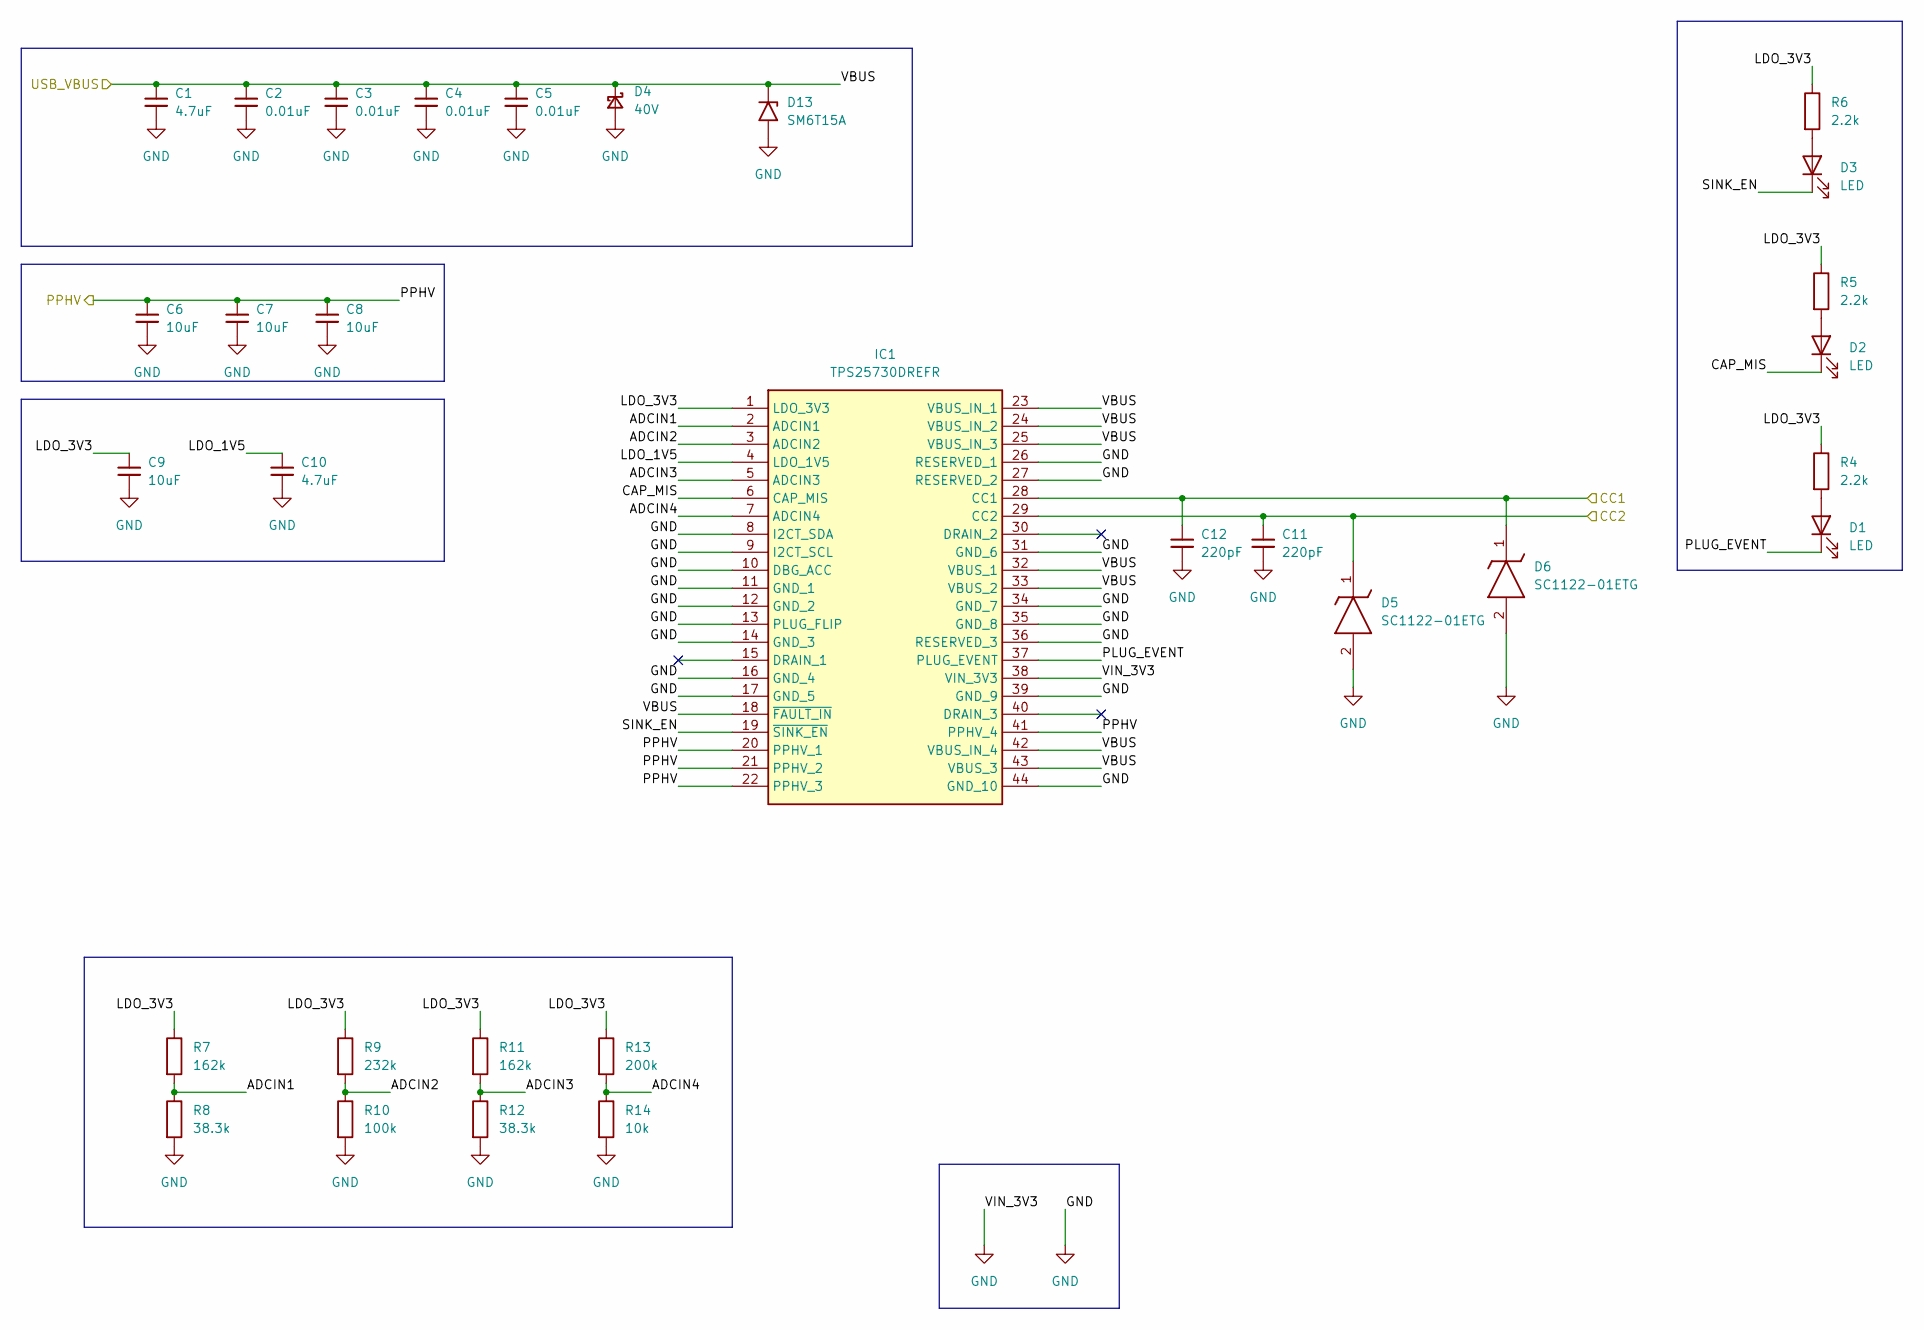
[picture p38: schematic USB-PD.kicad_sch, USB 15V PD Controller]

Parts:
C1, C10: 4.7uF; C_0805_2012Metric
C2, C3, C4, C5: 0.01uF; C_0805_2012Metric
C6, C7, C8, C9: 10uF; C_0805_2012Metric
C11, C12: 220pF; C_0805_2012Metric
D1, D2, D3: LED; LED_0805_2012Metric
D4: 40V; D_SMA_Handsoldering
D5, D6: SC1122-01ETG; SC112201ETG; Manufacturer_Part_Number SC1122-01ETG
D13: SM6T15A; D_SMB
IC1: TPS25730DREFR; Mouser Part Number 595-TPS25730DREFR
R4, R5, R6: 2.2k; R_0805_2012Metric
R7, R11: 162k; R_0805_2012Metric
R8, R12: 38.3k; R_0805_2012Metric
R9: 232k; R_0805_2012Metric
R10: 100k; R_0805_2012Metric
R13: 200k; R_0805_2012Metric
R14: 10k; R_0805_2012Metric

Connections:
/USB-PD/ADCIN1: IC1.2 (ADCIN1), R7.2, R8.1
/USB-PD/ADCIN2: IC1.3 (ADCIN2), R9.2, R10.1
/USB-PD/ADCIN3: IC1.5 (ADCIN3), R11.2, R12.1
/USB-PD/ADCIN4: IC1.7 (ADCIN4), R13.2, R14.1
/USB-PD/CAP_MIS: D2.1 (K), IC1.6 (CAP_MIS)
/USB-PD/CC1: C12.1, D6.1 (K), IC1.28 (CC1); also elsewhere on the board
/USB-PD/CC2: C11.1, D5.1 (K), IC1.29 (CC2); also elsewhere on the board
/USB-PD/LDO_1V5: C10.1, IC1.4 (LDO_1V5)
/USB-PD/LDO_3V3: C9.1, IC1.1 (LDO_3V3), R4.1, R5.1, R6.1, R7.1, R9.1, R11.1, R13.1
/USB-PD/PLUG_EVENT: D1.1 (K), IC1.37 (PLUG_EVENT)
/USB-PD/PPHV: C6.1, C7.1, C8.1, IC1.20 (PPHV_1), IC1.21 (PPHV_2), IC1.22 (PPHV_3), IC1.41 (PPHV_4); also elsewhere on the board
/USB-PD/SINK_EN: D3.1 (K), IC1.19 (~SINK_EN)
/USB-PD/VBUS: C1.1, C2.1, C3.1, C4.1, C5.1, D4.1 (K), D13.1 (A1), IC1.18 (~FAULT_IN), IC1.23 (VBUS_IN_1), IC1.24 (VBUS_IN_2), IC1.25 (VBUS_IN_3), IC1.32 (VBUS_1), IC1.33 (VBUS_2), IC1.42 (VBUS_IN_4), IC1.43 (VBUS_3); also elsewhere on the board
GND: C1.2, C2.2, C3.2, C4.2, C5.2, C6.2, C7.2, C8.2, C9.2, C10.2, C11.2, C12.2, D4.2 (A), D5.2 (A), D6.2 (A), D13.2 (A2), IC1.8 (I2CT_SDA), IC1.9 (I2CT_SCL), IC1.10 (DBG_ACC), IC1.11 (GND_1), IC1.12 (GND_2), IC1.13 (PLUG_FLIP), IC1.14 (GND_3), IC1.16 (GND_4), IC1.17 (GND_5), IC1.26 (RESERVED_1), IC1.27 (RESERVED_2), IC1.31 (GND_6), IC1.34 (GND_7), IC1.35 (GND_8), IC1.36 (RESERVED_3), IC1.38 (VIN_3V3), IC1.39 (GND_9), IC1.44 (GND_10), R8.2, R10.2, R12.2, R14.2; also elsewhere on the board
unnamed: D1.2 (A), R4.2
unnamed: D2.2 (A), R5.2
unnamed: D3.2 (A), R6.2

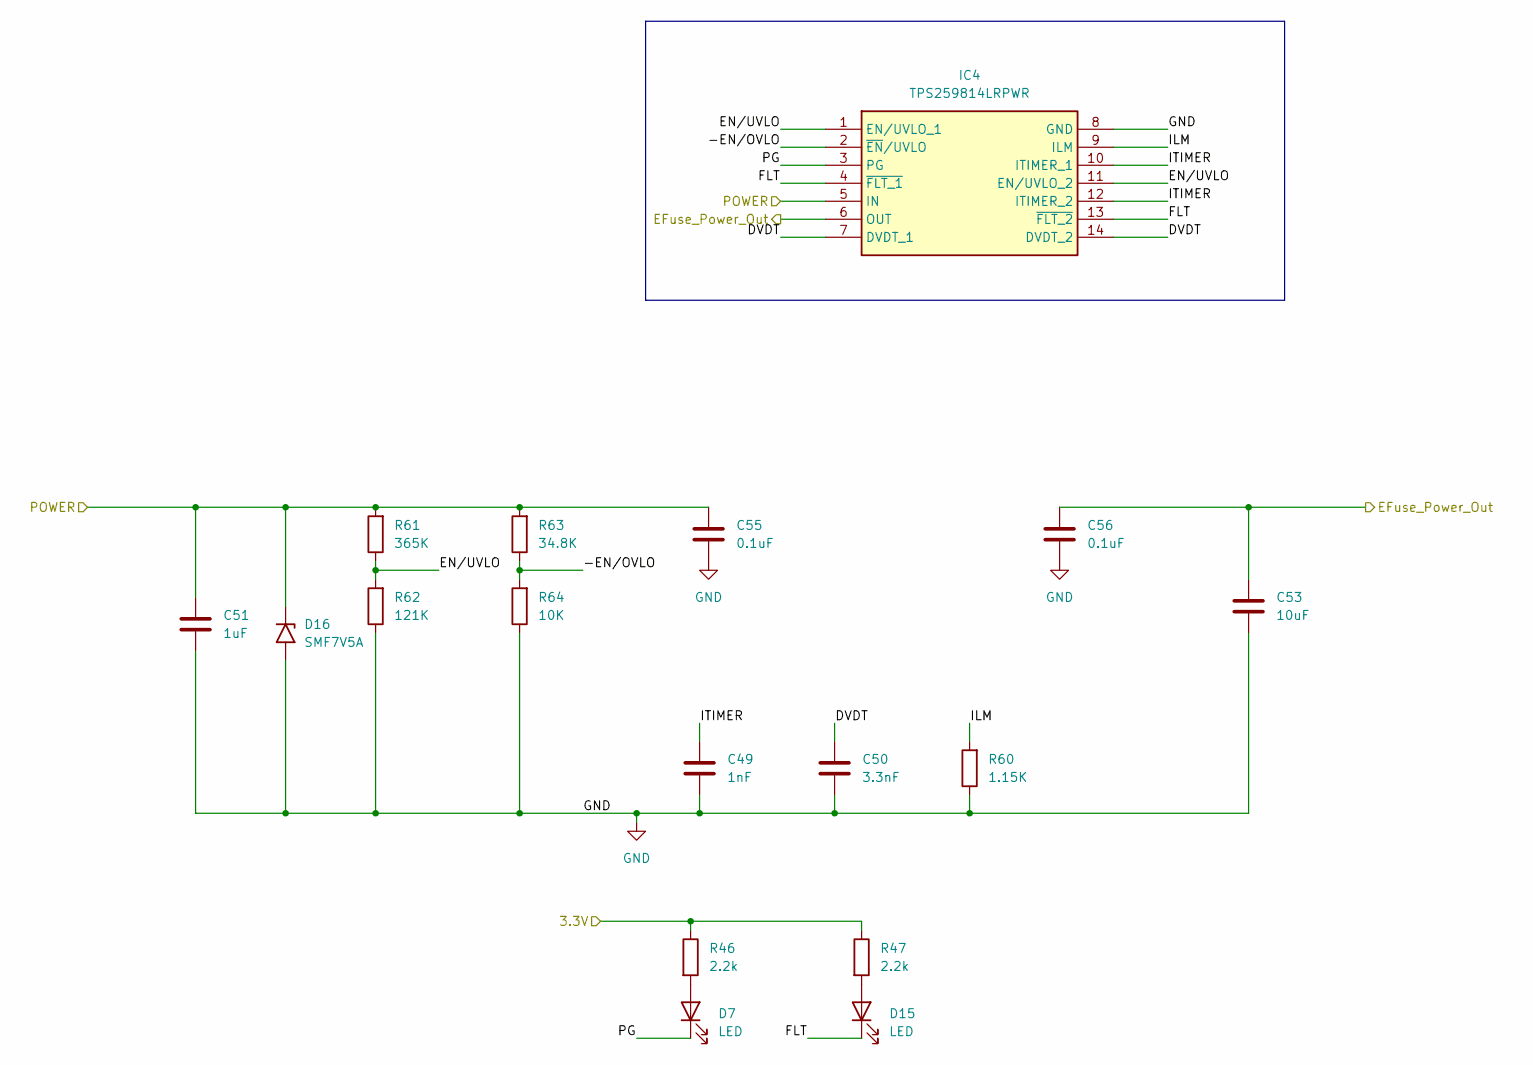
[picture p39: schematic EFuse.kicad_sch]

Parts:
C49: 1nF; C_0805_2012Metric
C50: 3.3nF; C_0805_2012Metric
C51: 1uF; C_0805_2012Metric
C53: 10uF; C_0805_2012Metric
C55, C56: 0.1uF; C_0805_2012Metric
D7, D15: LED; LED_0805_2012Metric
D16: SMF7V5A; D_SMF
IC4: TPS259814LRPWR; TPS259470ARPWR; Manufacturer_Part_Number TPS259814LRPWR
R46, R47: 2.2k; R_0805_2012Metric
R60: 1.15K; R_0805_2012Metric
R61: 365K; R_0805_2012Metric
R62: 121K; R_0805_2012Metric
R63: 34.8K; R_0805_2012Metric
R64: 10K; R_0805_2012Metric

Connections:
/Battery_Charger/VREF: R46.1, R47.1; also elsewhere on the board
/Buck/VOUT: C51.2, C55.2, D16.1 (A1), IC4.5 (IN), R61.2, R63.2; also elsewhere on the board
/EFuse/-EN/OVLO: IC4.2 (~EN/UVLO), R63.1, R64.2
/EFuse/DVDT: C50.2, IC4.7 (DVDT_1), IC4.14 (DVDT_2)
/EFuse/EFuse_Power_Out: C53.2, C56.2, IC4.6 (OUT); also elsewhere on the board
/EFuse/EN/UVLO: IC4.1 (EN/UVLO_1), IC4.11 (EN/UVLO_2), R61.1, R62.2
/EFuse/FLT: D15.1 (K), IC4.4 (~FLT_1), IC4.13 (~FLT_2)
/EFuse/ILM: IC4.9 (ILM), R60.2
/EFuse/ITIMER: C49.2, IC4.10 (ITIMER_1), IC4.12 (ITIMER_2)
/EFuse/PG: D7.1 (K), IC4.3 (PG)
GND: C49.1, C50.1, C51.1, C53.1, C55.1, C56.1, D16.2 (A2), IC4.8 (GND), R60.1, R62.1, R64.1; also elsewhere on the board
unnamed: D7.2 (A), R46.2
unnamed: D15.2 (A), R47.2

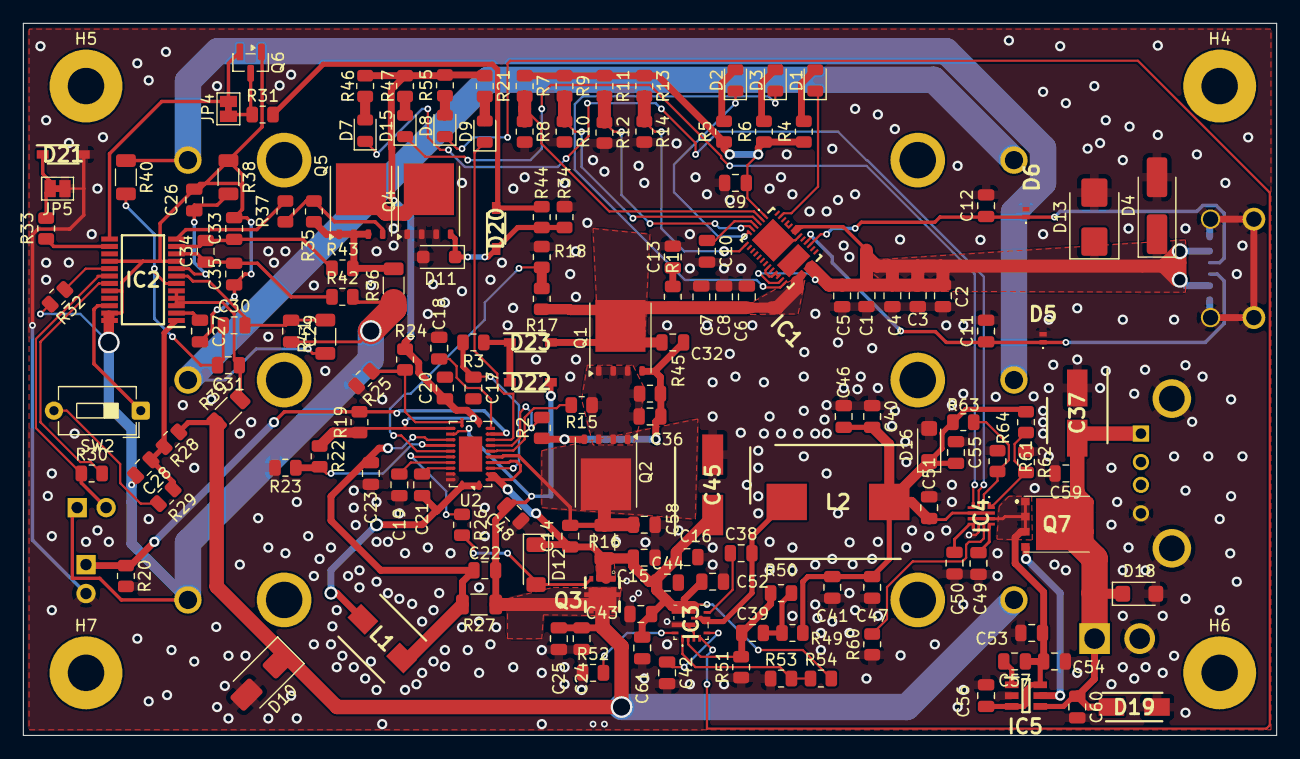
[picture p40: board USB_UPS_Raspberry.kicad_pcb from above]

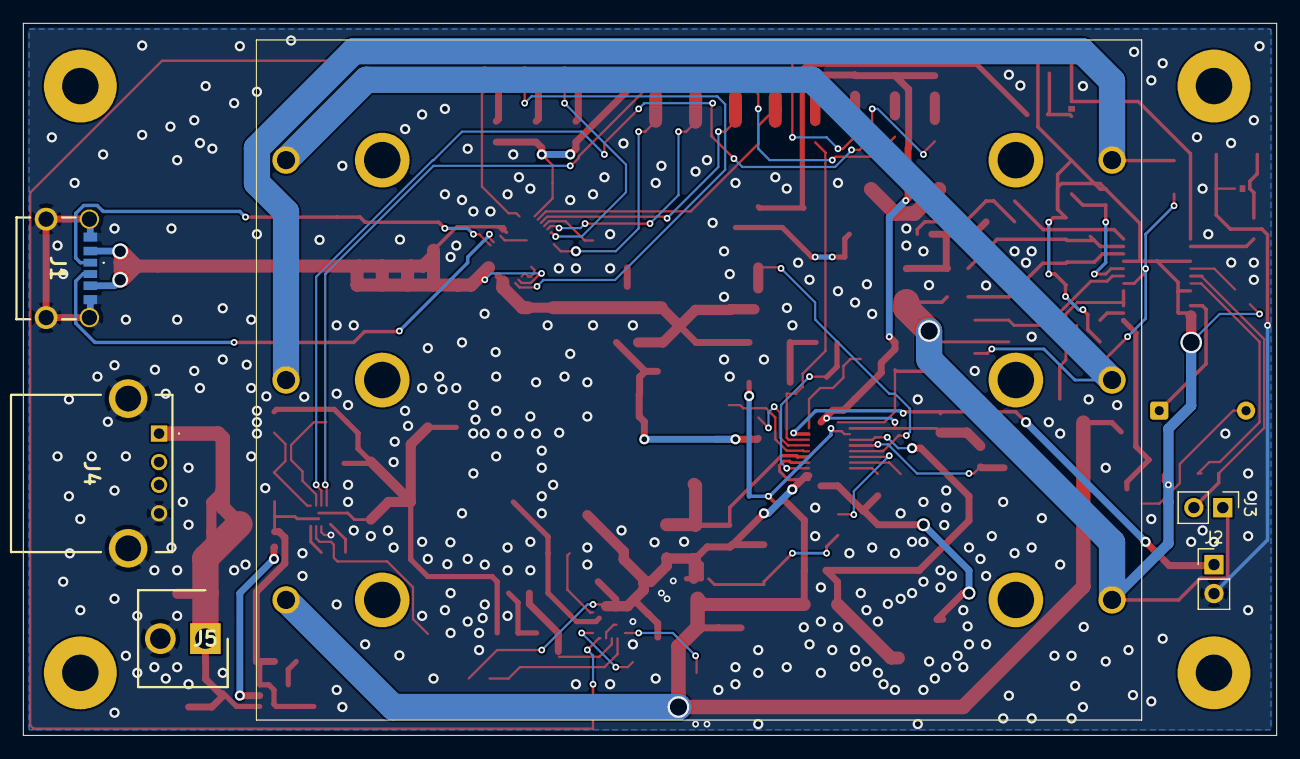
[picture p41: board USB_UPS_Raspberry.kicad_pcb from below]

Board: 2 copper layers, 110.0 x 62.5 mm, 169 parts (6 on the bottom side), 90 nets.
