asheryoung10/seniorProject/(commit log)

2026-08-28 Add image of housing shell to README
    Added an image to the README for better visual representation.
2026-08-28 Enhance README with project details and media
    Expanded the README to include project goals, progress, prototype details, data collection methods, and project structure.
2026-10-17 Added new CAD files
2026-10-31 UPS power supply schematic and KiCad files
2026-11-03 Added raspberry pi updated code
2026-11-05 close to finished UPS design, need to add BOM and pick and place
